Szu-Chi/Ant_Robot/img/Final2 v11.png

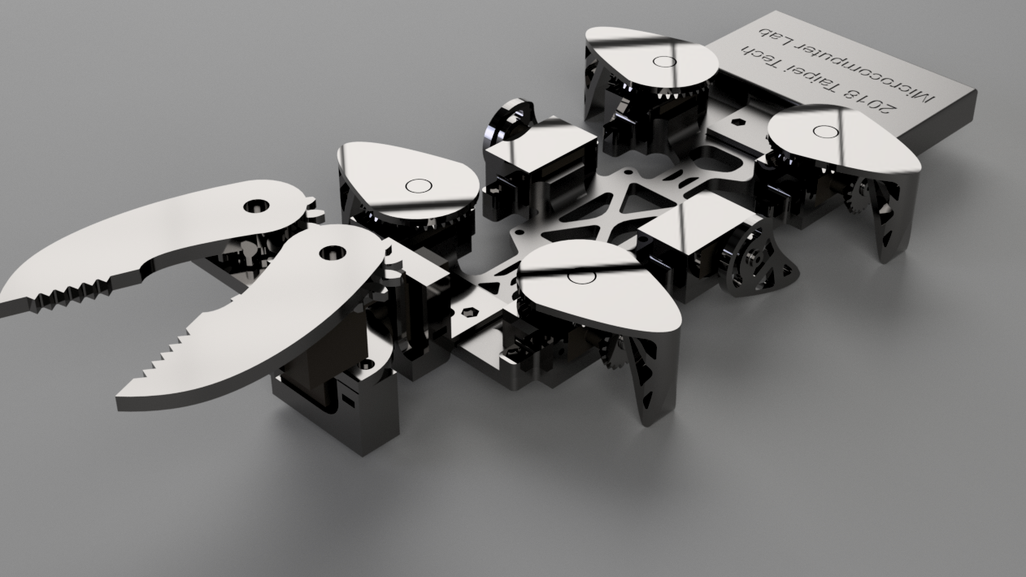
img/Final2 v11.png
