Szu-Chi/Ant_Robot/img/Final2 v12-1.png

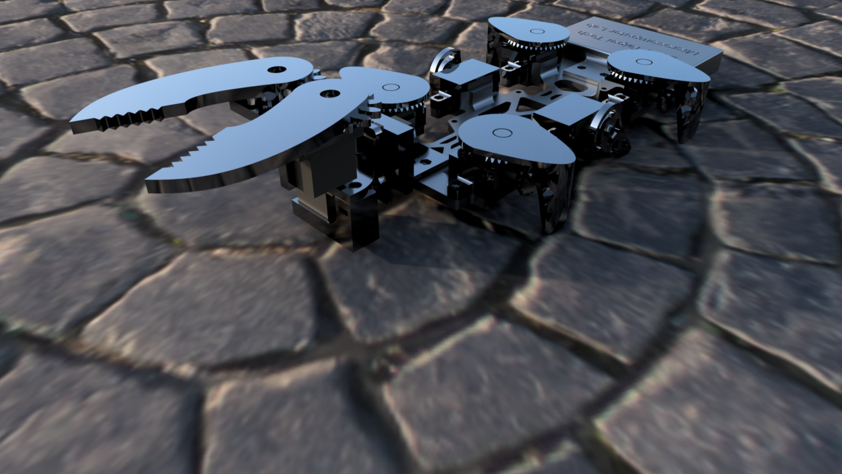
img/Final2 v12-1.png
