Szu-Chi/Ant_Robot/circuit/README.md

## **Note**

All the circuits here, its custom made for milling machines only  !!!
Not for PCB manufacturing !!!

And the controller board is a shield-type PCB
just for our class used the development board
