Szu-Chi/Ant_Robot/doc/微算機原理與應用.pdf

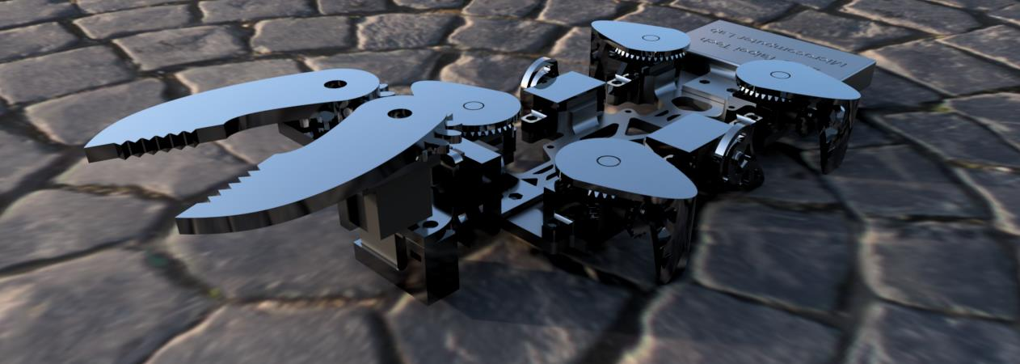
[picture p3: page 1]

# 微算機原理與應用

106360210劉紹祥
106360218莊詠鈞
106360231黃思齊

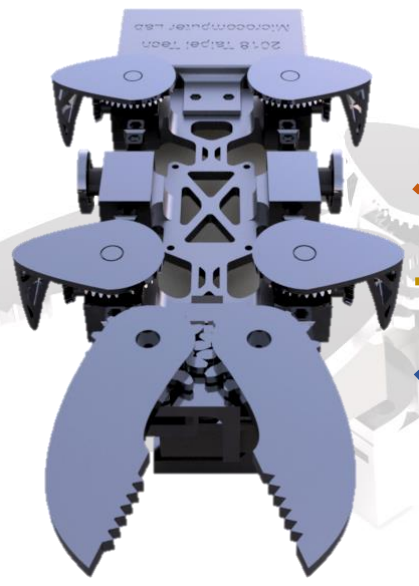
[picture p4: figure]

機構

程式

電路

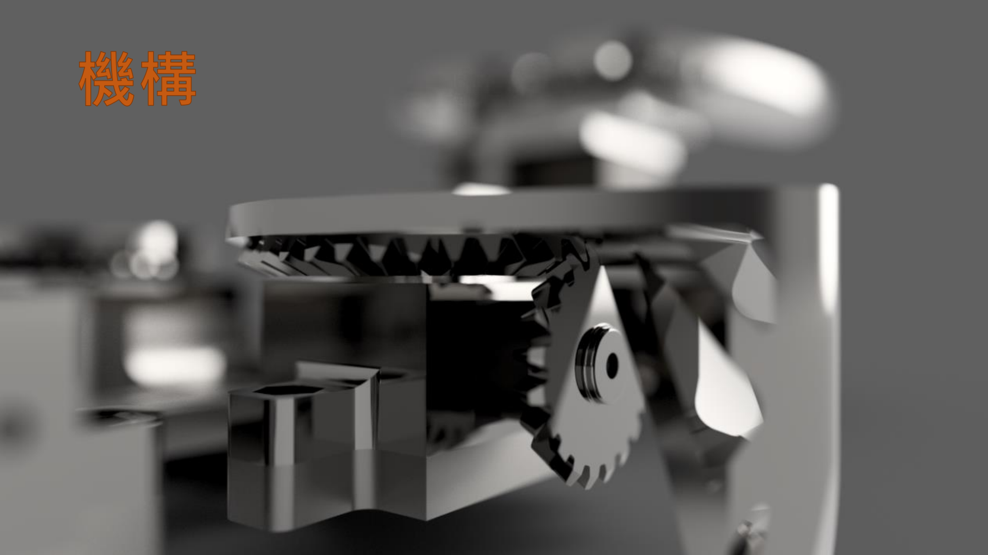
[picture p5: page 3]

# 伺服馬達 MG90

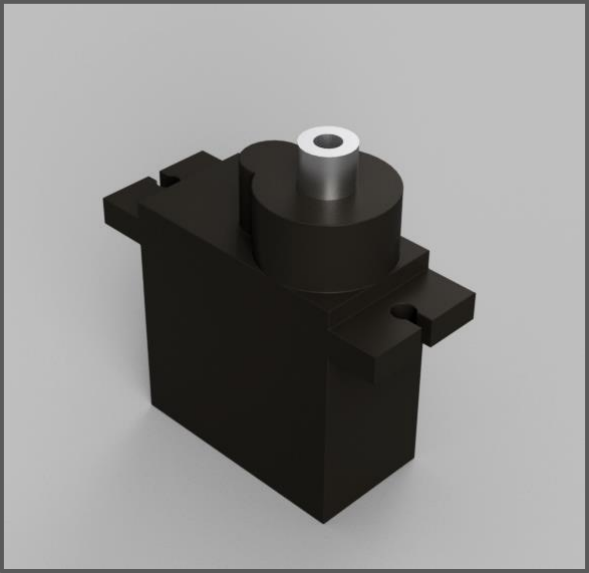
[picture p6: figure]

機構

程式

電路

# 馬達座

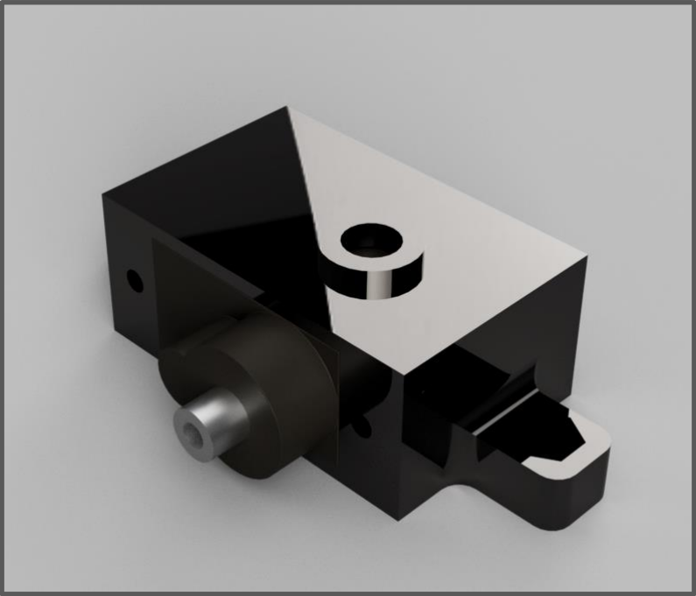
[picture p7: figure]

機構

程式

電路

# 傘齒輪設計

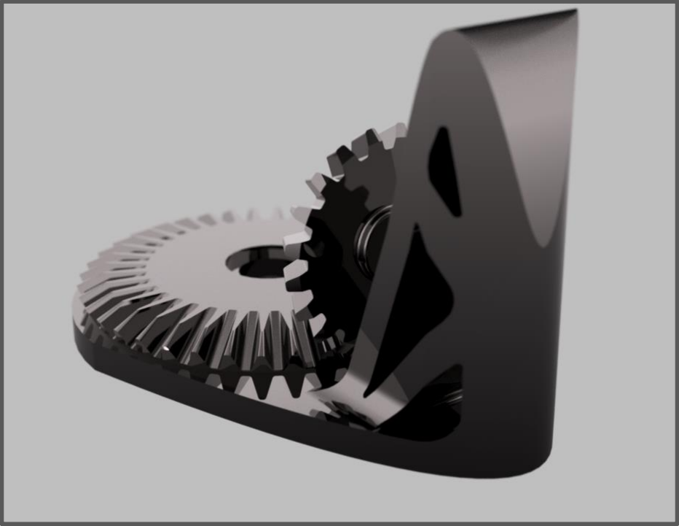
[picture p8: figure]

機構

程式

電路

# 馬達齒輪組固定

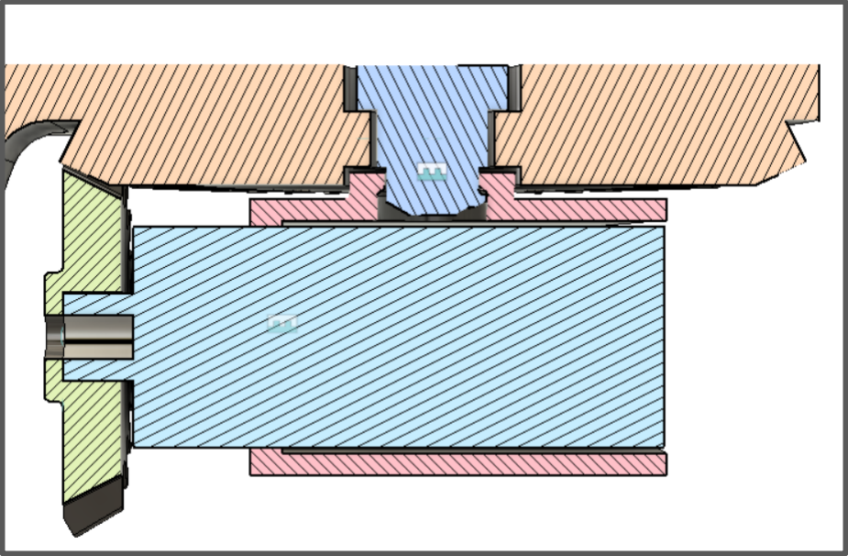
[picture p9: figure]

機構

程式

電路

# 組裝平台

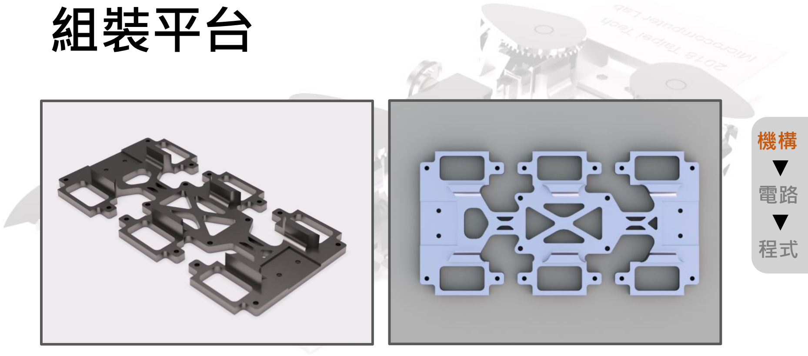
[picture p10: page 8]

機構

程式

電路

# 電池盒

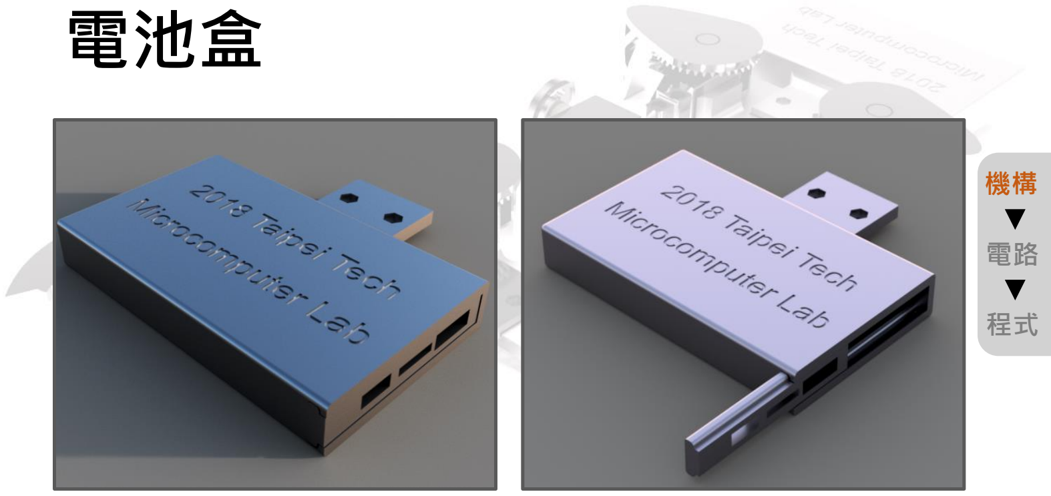
[picture p11: page 9]

機構

程式

電路

# 三軸平台

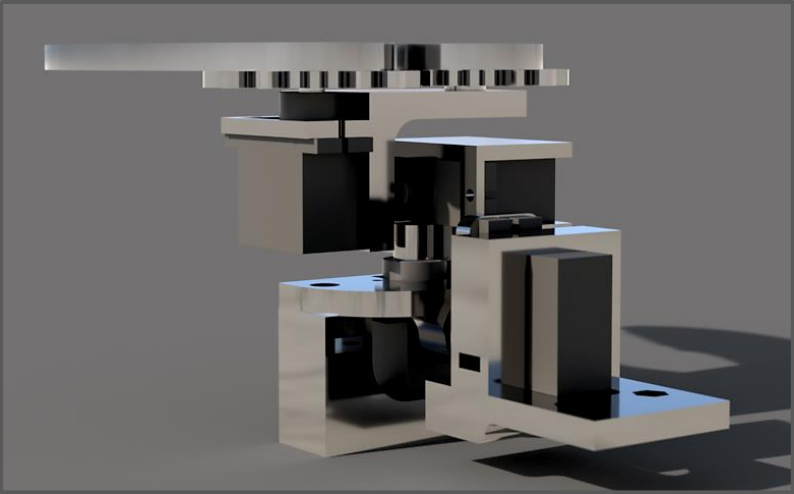
[picture p12: figure]

機構

程式

電路

夾子

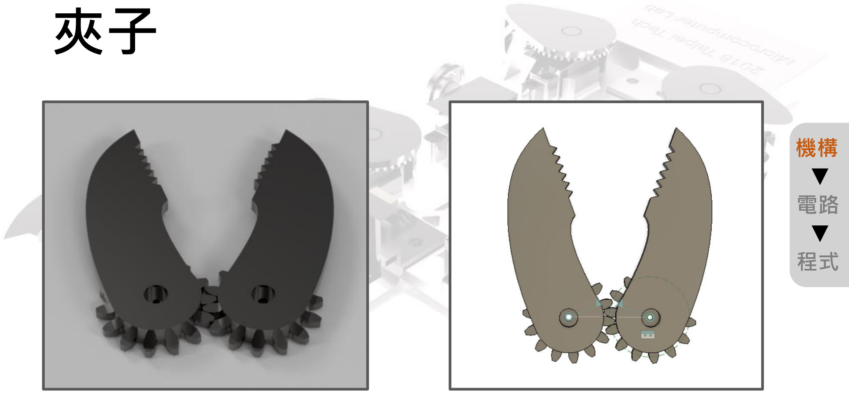
[picture p13: page 11]

機構

程式

電路

# 整體配置

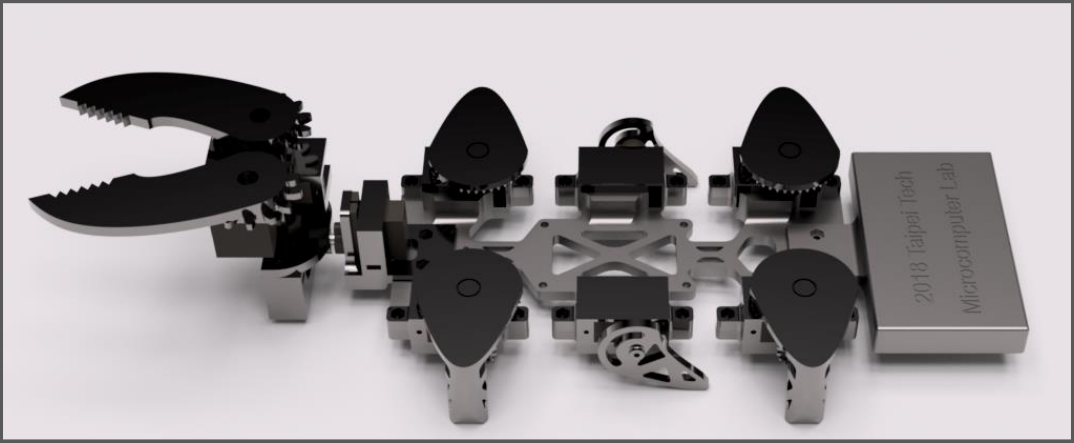
[picture p14: figure]

機構

程式

電路

# 整體配置

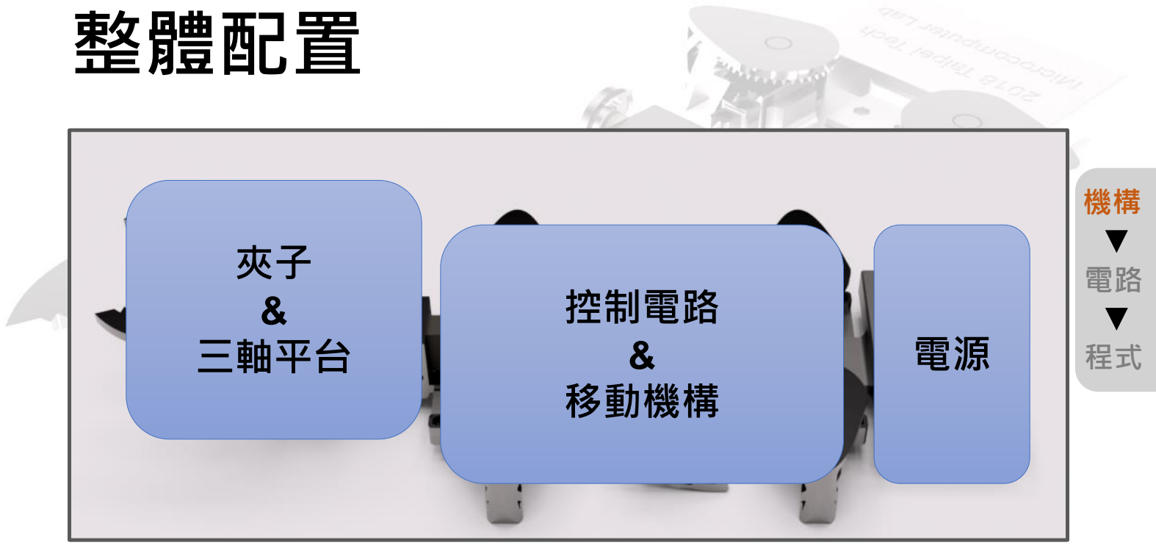
[picture p15: page 13]

機構

程式

## 電路 控制電路 &

## 移動機構

電源

夾子&

## 三軸平台

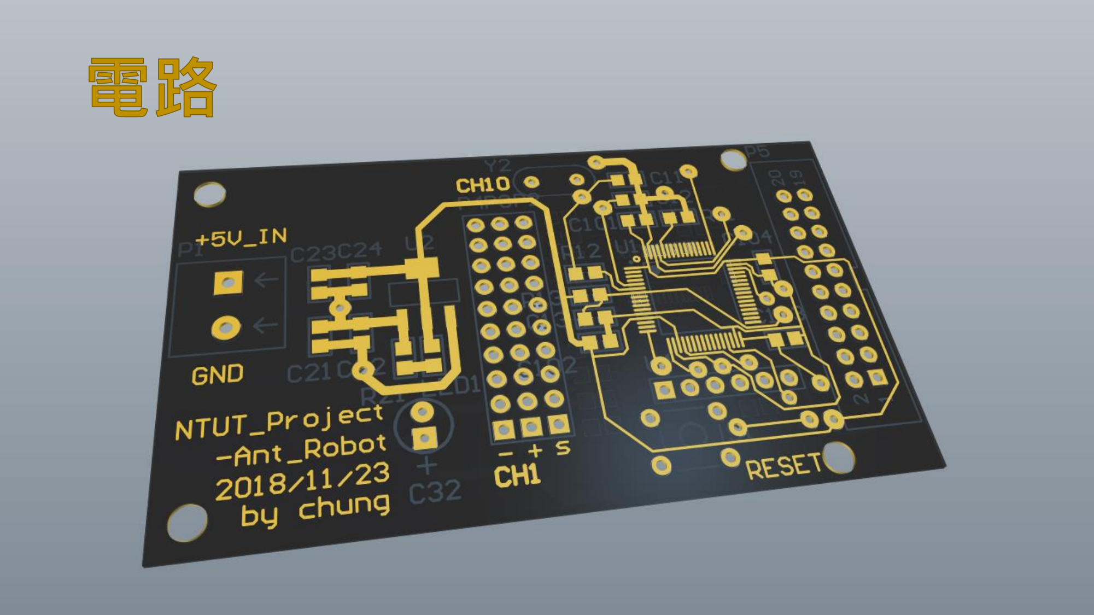
[picture p16: page 14]

電路

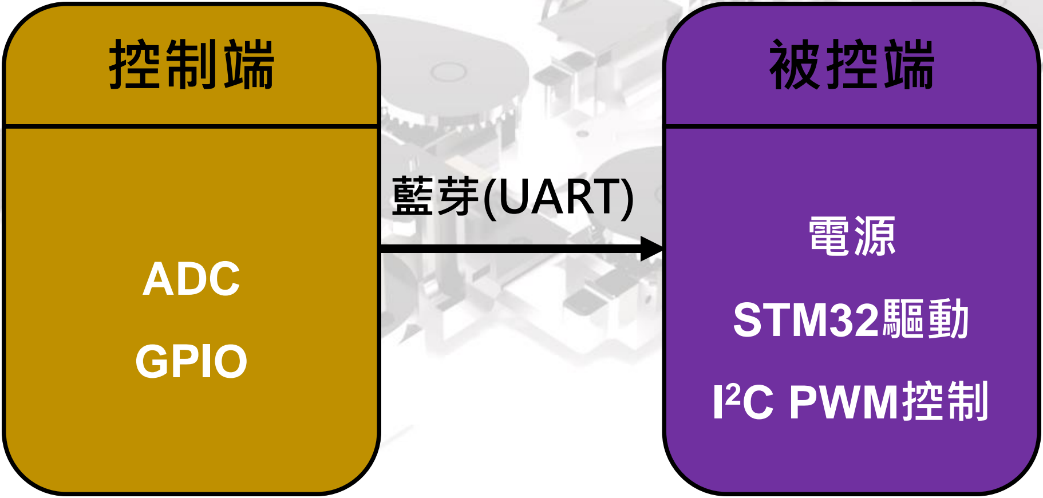
[picture p17: figure]
ADC; GPIO; 控制端; STM32驅動; 2C PWM控制; 被控端; 藍芽(UART)

機構

程式

電路

# 控制端電路

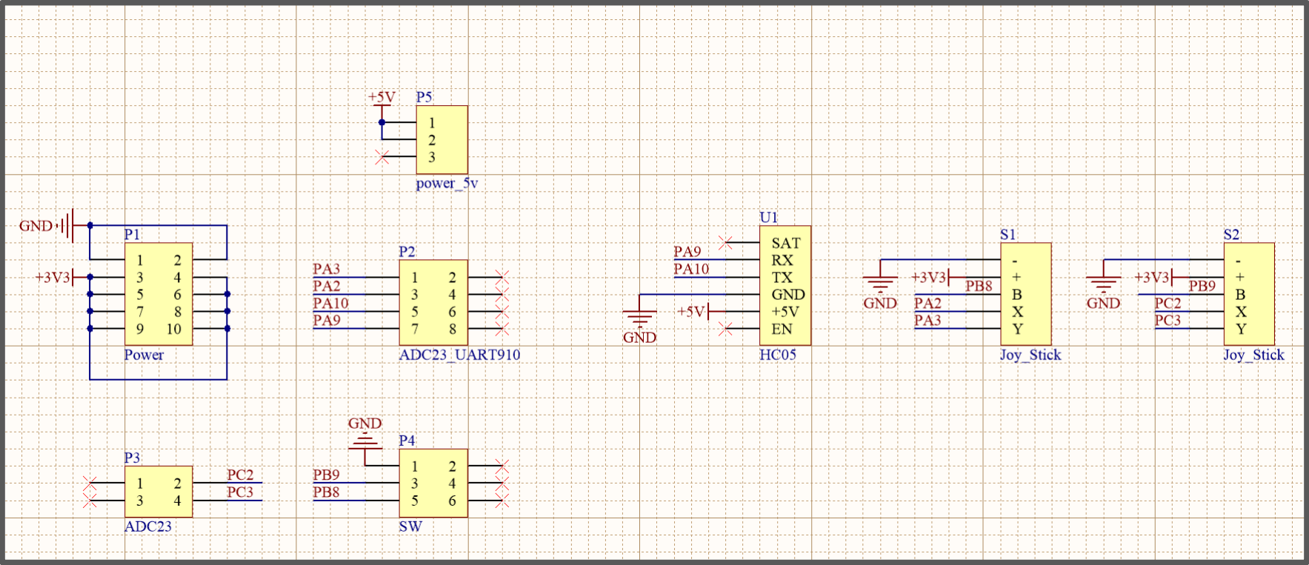
[picture p18: figure]

機構

程式

電路

搖桿

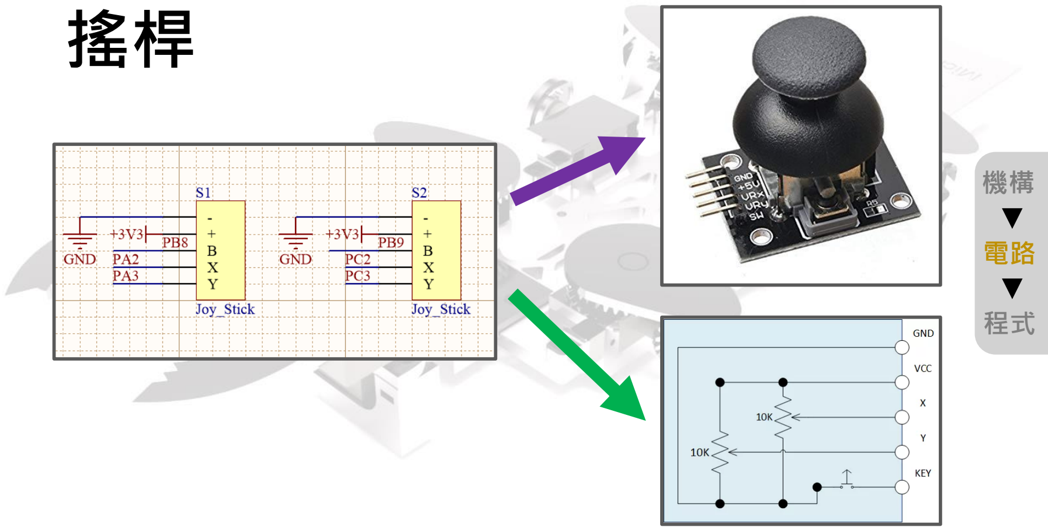
[picture p19: page 17]

機構

程式

電路

# 藍芽模組(HC-05)

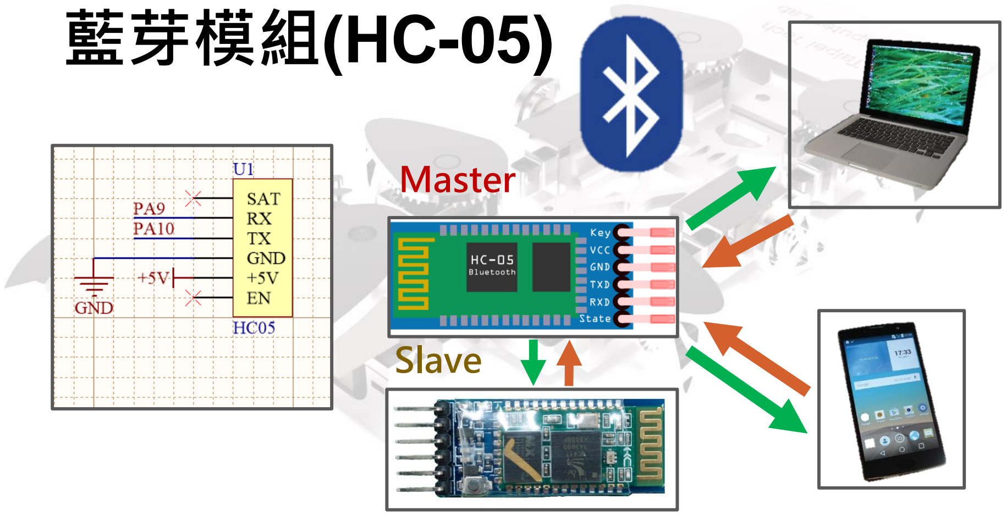
[picture p20: page 18]

## Master

## Slave

# 被控端電路

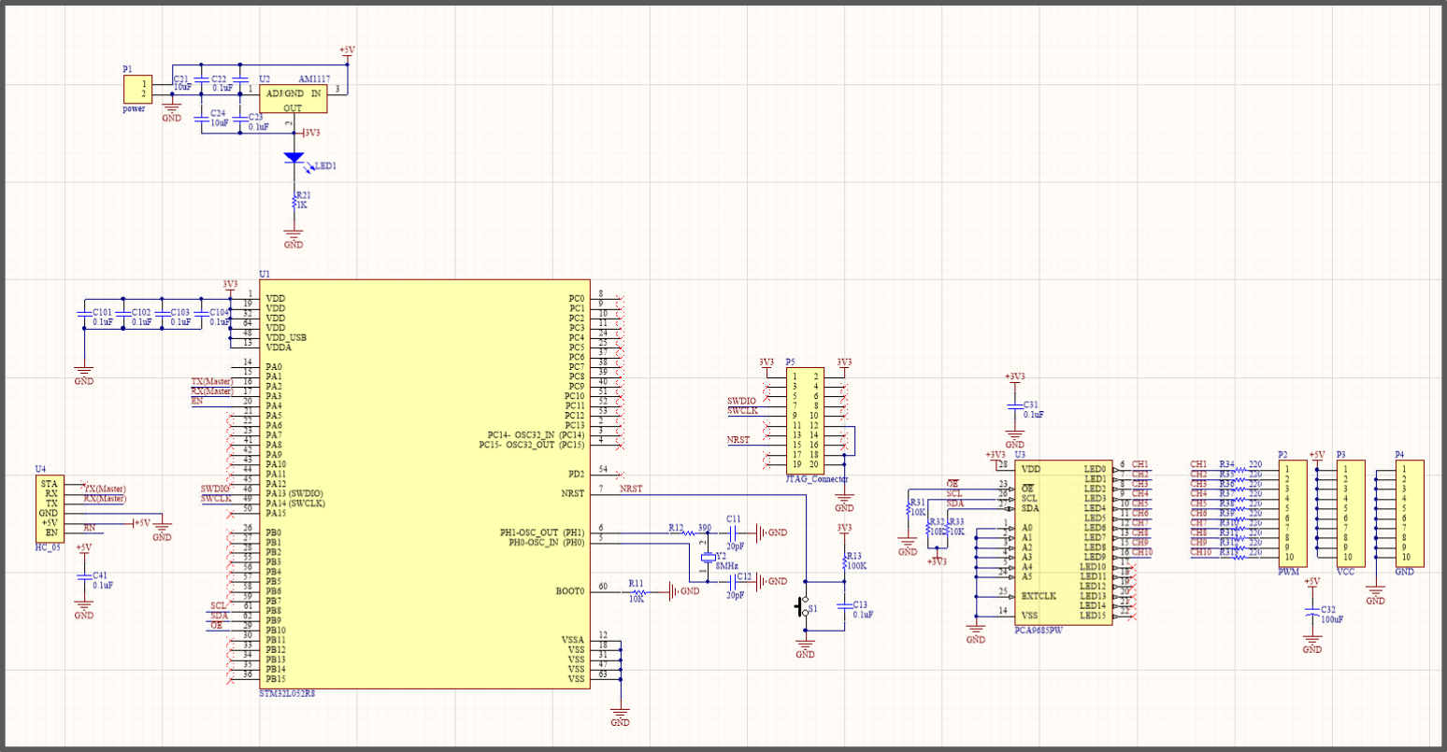
[picture p21: figure]

機構

程式

電路

# 電源電路

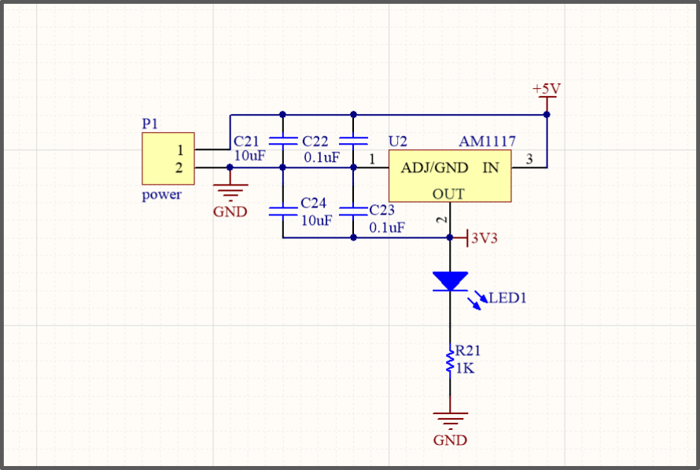
[picture p22: figure]

機構

程式

電路

# STM32驅動電路

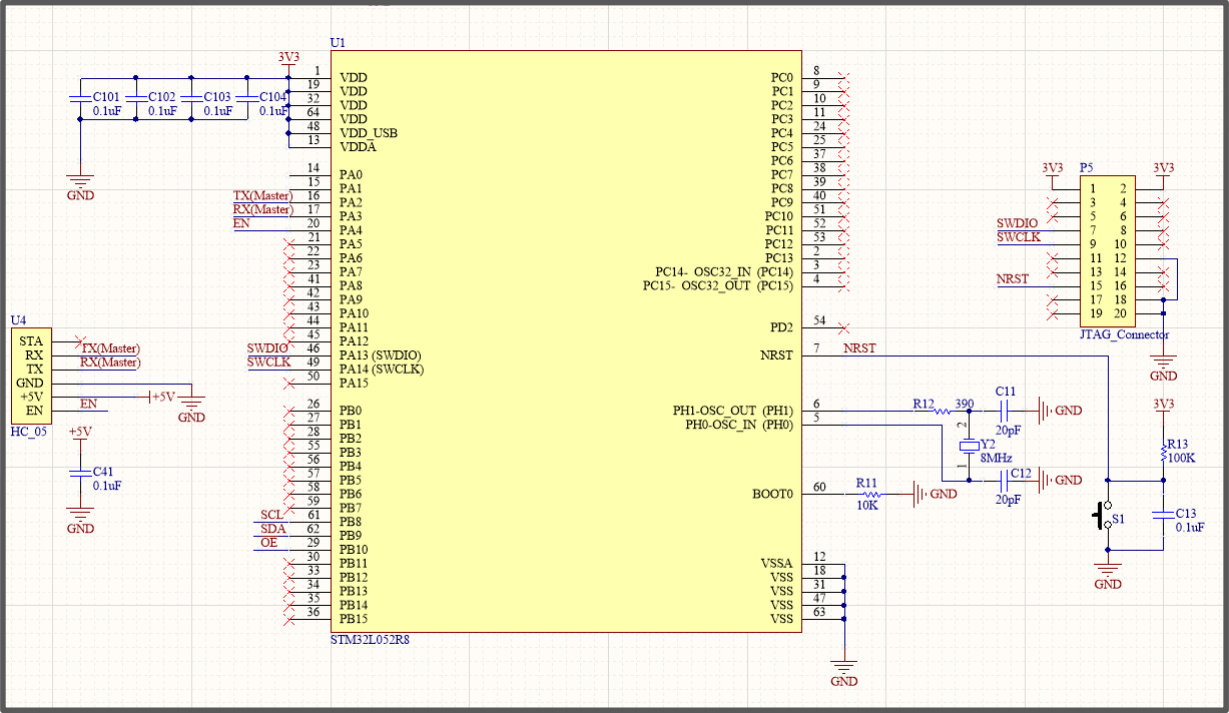
[picture p23: figure]

機構

程式

電路

# I2C PWM驅動IC(PCA9685)

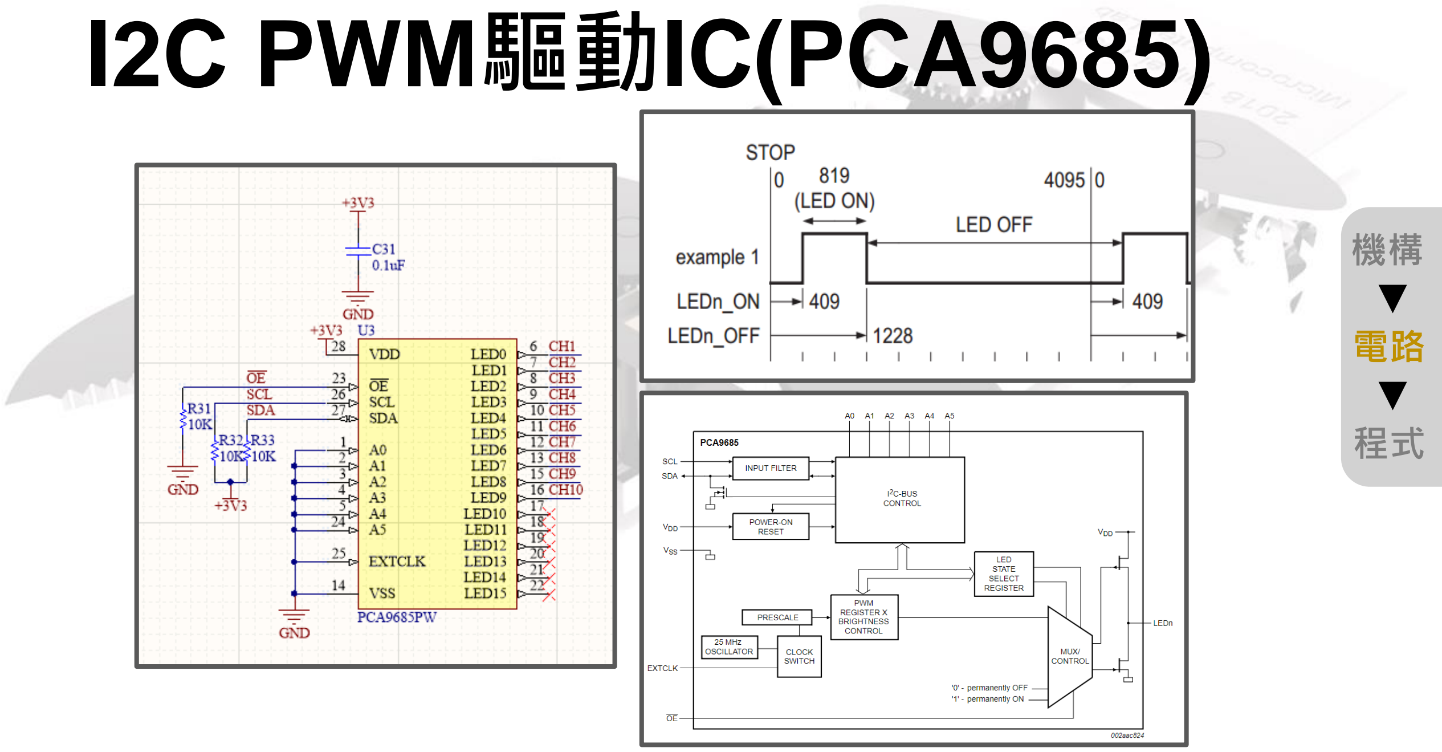
[picture p24: page 22]

機構

程式

電路

# 伺服馬達

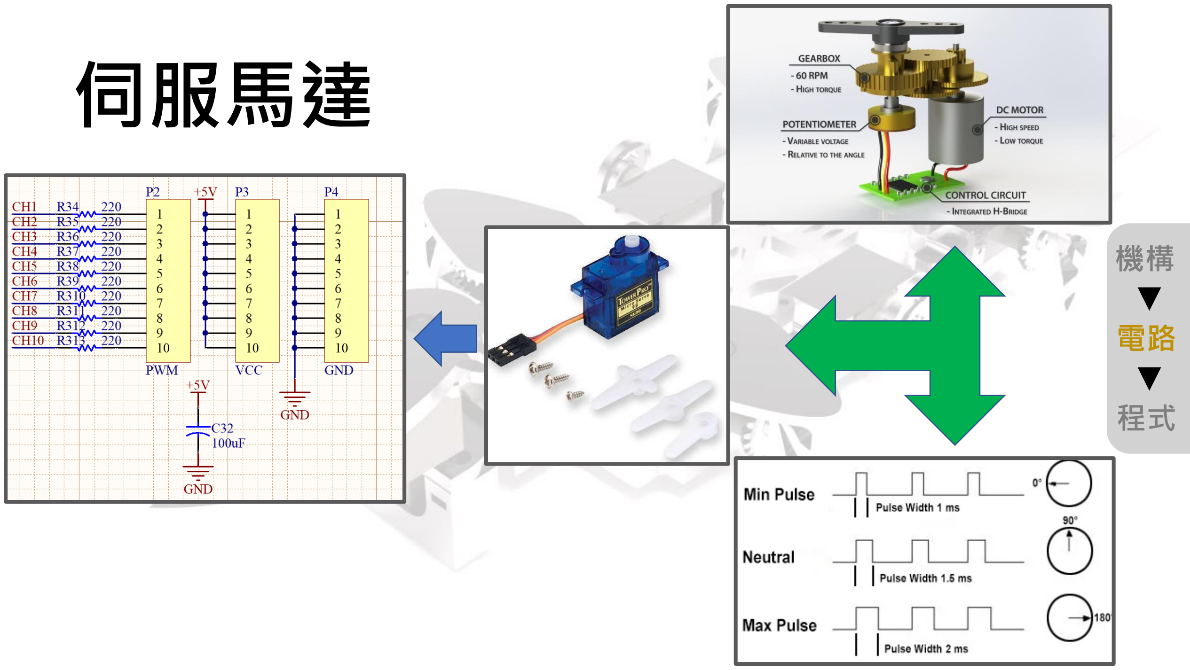
[picture p25: page 23]

機構

程式

電路

# PCB Layout

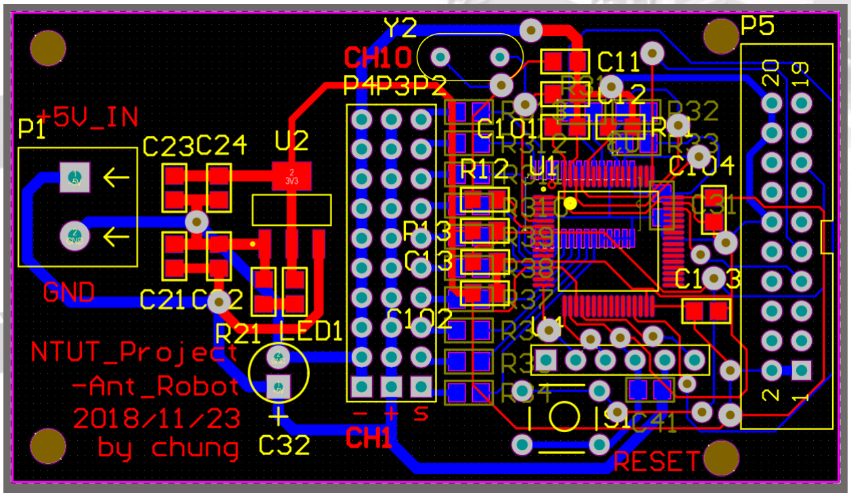
[picture p26: figure]

機構

程式

電路

# PCB Layout

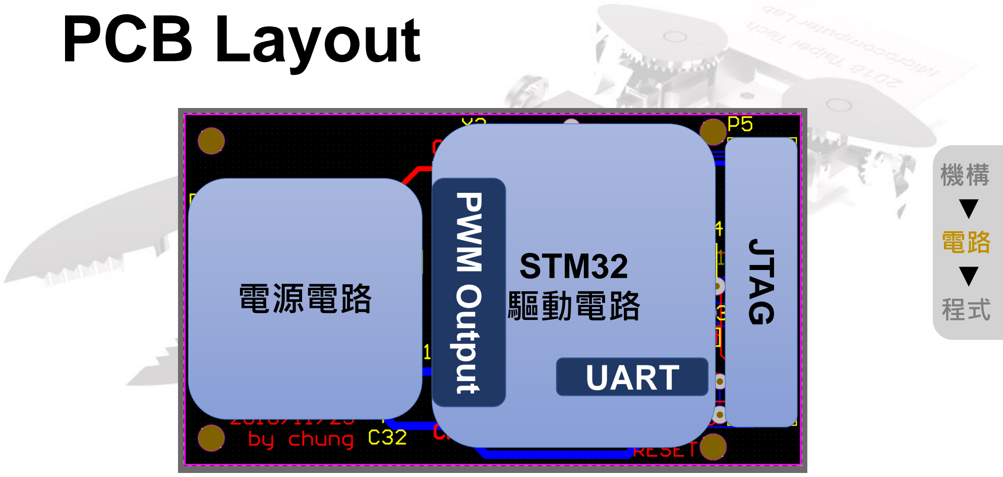
[picture p27: page 25]

## STM32

## 驅動電路

## 電源電路

## JTAG

## UART

## PWM Output

機構

程式

電路

# Gerber file & NC drill

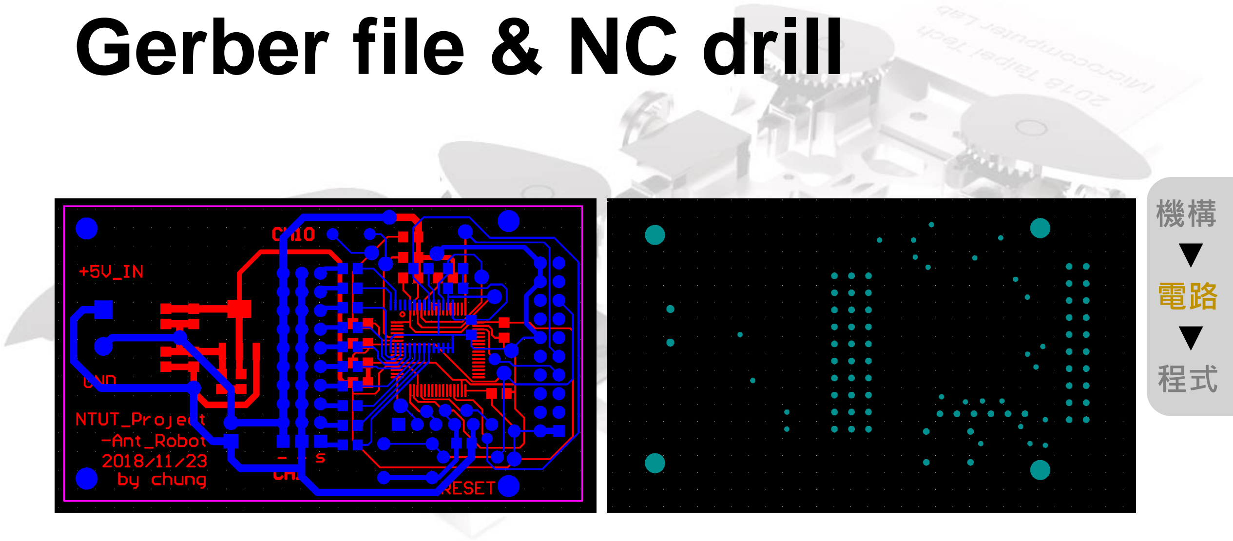
[picture p28: page 26]

機構

程式

電路

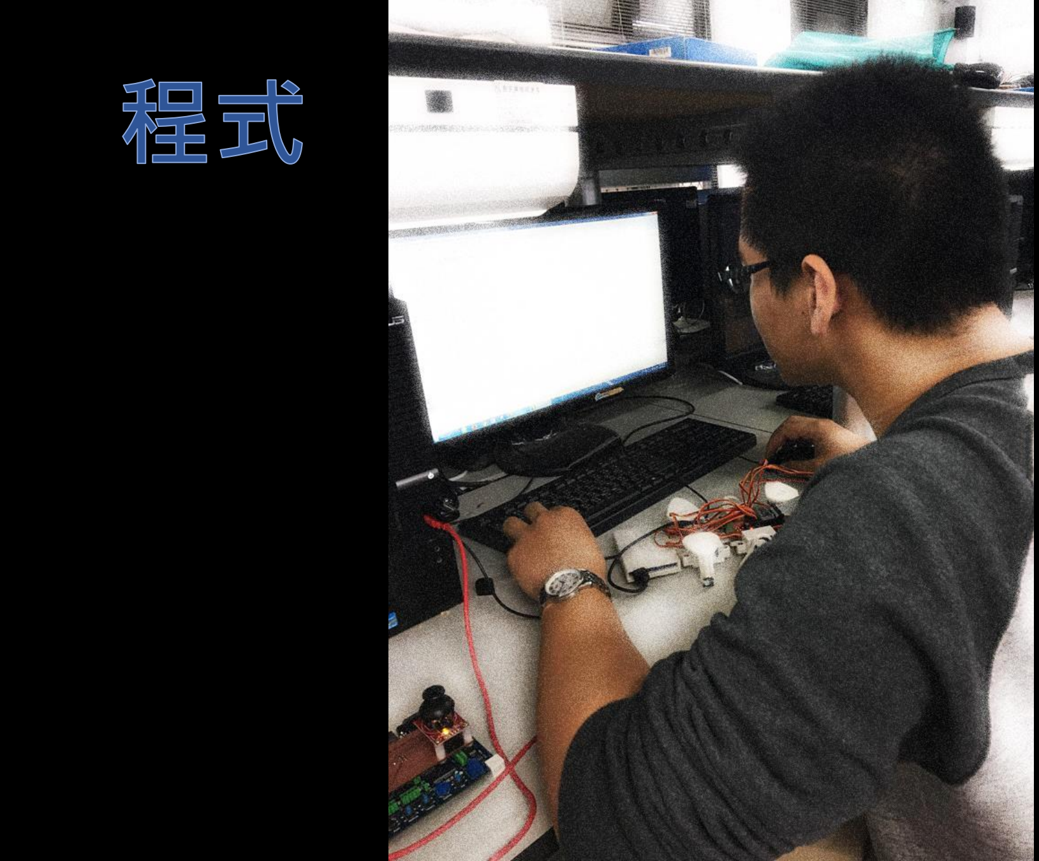
[picture p29: figure]

機構

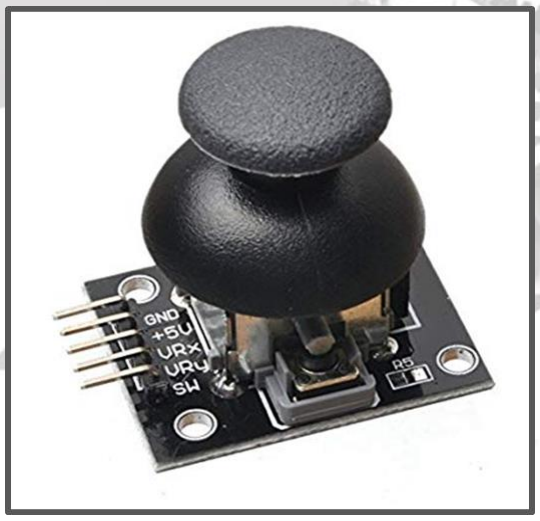
[picture p30: figure]
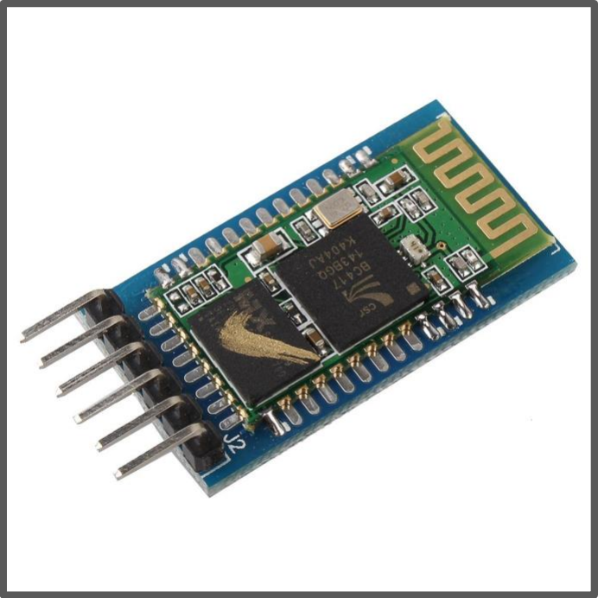
[picture p31: figure]

程式

電路

# 控制端

ADC DMA | UART

# DMA

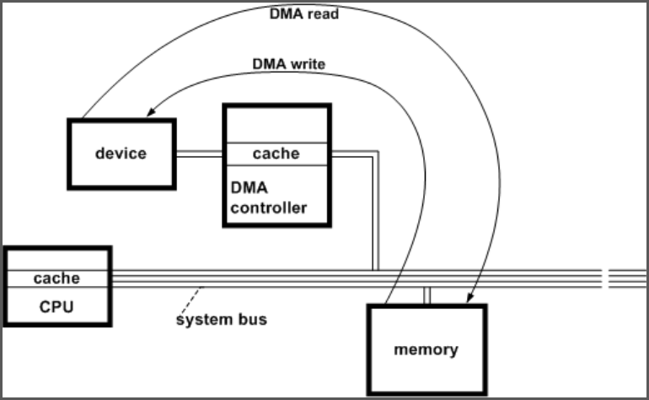
[picture p32: figure]

機構

程式

電路

# ADC DMA

機構

程式

電路

HAL_ADC_Start_DMA(&hadc1,adc_temp,5);

uint32_t X1_Value=2048,Y1_Value=2048,X2_Value=0,Y2_Value=0,VR_Value=0;

void HAL_ADC_ConvCpltCallback(ADC_HandleTypeDef* hadc) {
X1_Value = adc_temp[0];
Y1_Value = adc_temp[1];
X2_Value = adc_temp[2];
Y2_Value = adc_temp[3];
VR_Value = adc_temp[4];
}

# UART Package

機構

程式

電路

4 | 5 | 6 | 7
Angle3 | SW_Clip | End | NC
0 | 1 | 2 | 3
Command | Speed | Angle1 | Angle2

機構

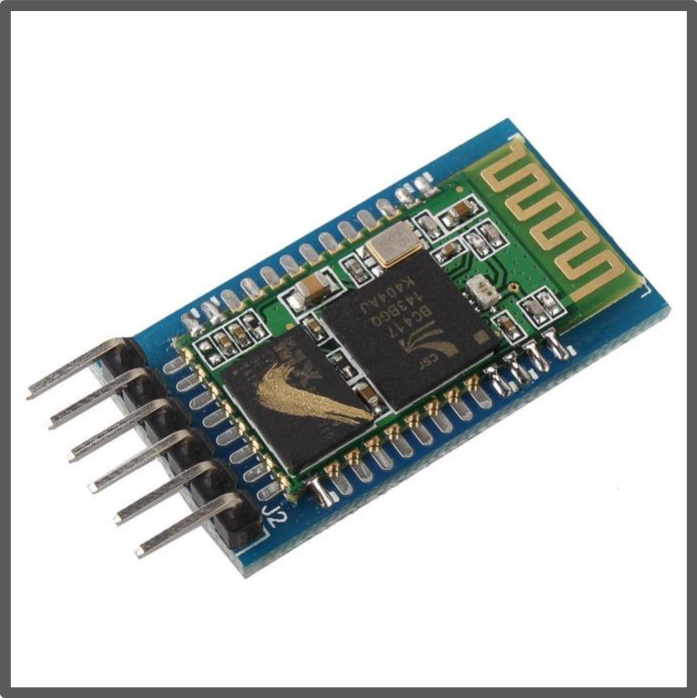
[picture p33: figure]
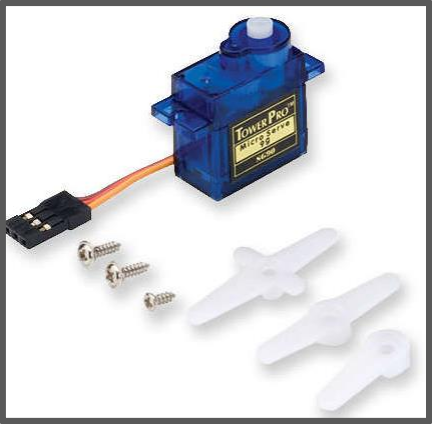
[picture p34: figure]
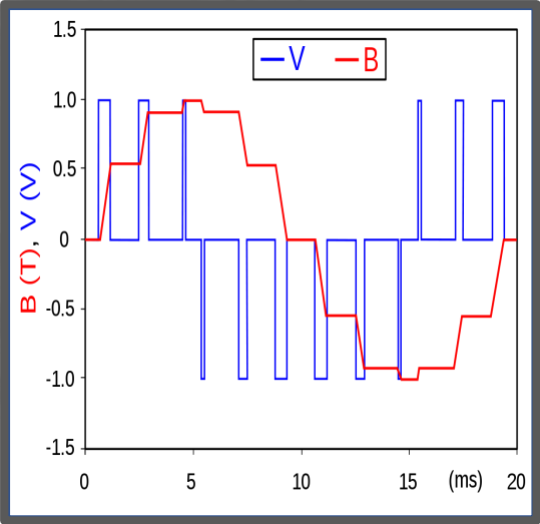
[picture p35: figure]

程式

電路

# 被控端

UART | setAngle | setPWM

# Main loop

while (1) {

if(command=='F') { Move_Forword(); }

else if(command=='R') { Turn_Right(); }

else if(command=='L') { Turn_Left(); }

else if(command=='S') { Reset_Position(); }

}

機構

程式

電路

# Decoding UART Package

void HAL_UART_RxCpltCallback(UART_HandleTypeDef *huart) { if(huart->Instance==USART2) { if(str1[6]=='E’) {
command = str1[0]; speed = str1[1]; angle1 = (int)str1[2]; angle2 = (int)str1[3]; angle3 = (int)str1[4]; clip = str1[5];
}
HAL_UART_Receive_IT(&huart2,str1,7); //Enable rx interrupt every time
}
}

機構

程式

電路

# setAngle

void setAngle(uint8_t num, uint8_t angle){

int pulse_wide, analog_value;

pulse_wide = map(angle, 0, 180, MIN_PULSE_WIDTH, MAX_PULSE_WIDTH);

analog_value = (int)((float)(pulse_wide) / 1000000 * 50 * 4096);

setPWM(num,0,analog_value);

}

機構

程式

電路

# setPWM - I

2C

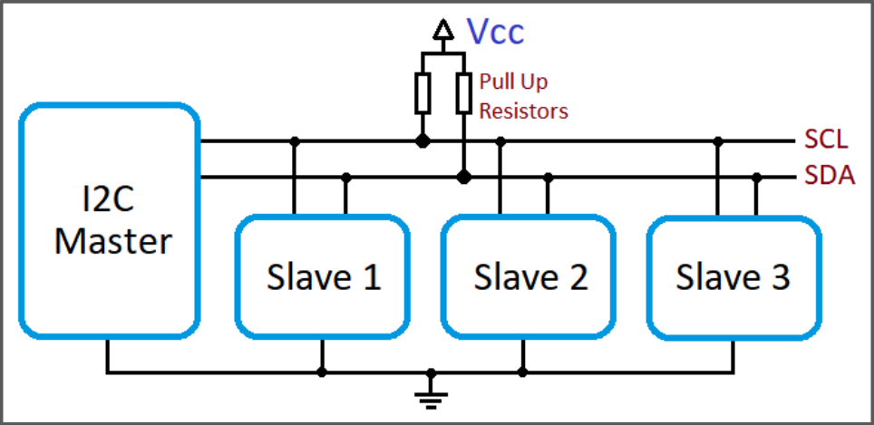
[picture p36: figure]

機構

程式

電路

# setPWM

機構

程式

電路

void setPWM(uint8_t num, uint16_t on, uint16_t off) { uint8_tdata_buf[]={on,(on>>8),off,(off>>8)}; I2C_WRITE_buf(LED0_ON_L+4*(num),data_buf,4); }

Slave address | Control register | Data for register
1 | A5:A0 | D7:D0 | D7:D0

# 成品照1

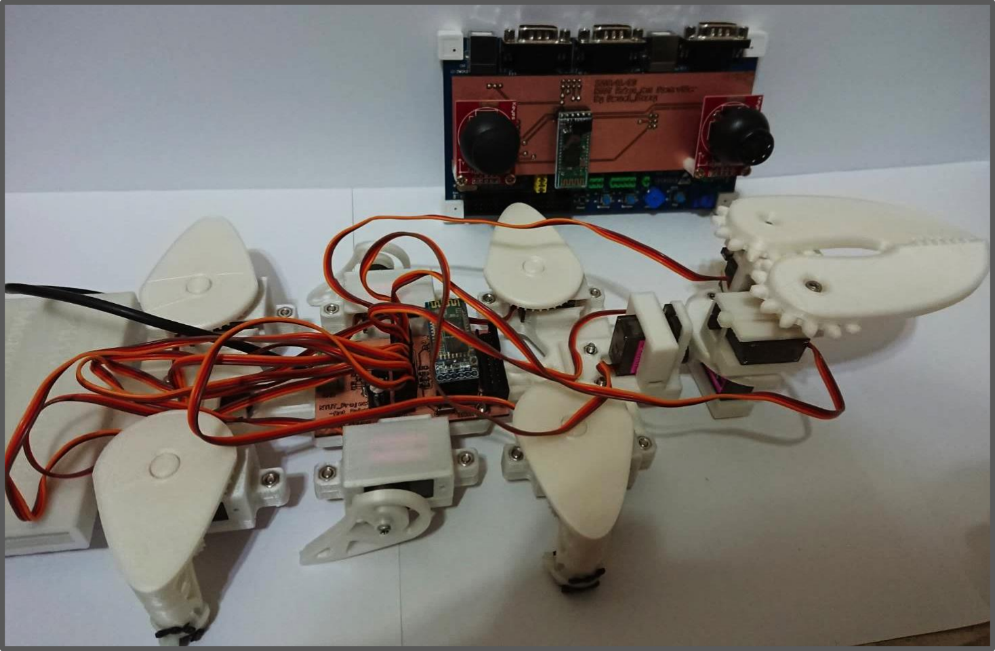
[picture p37: figure]

# 成品照2

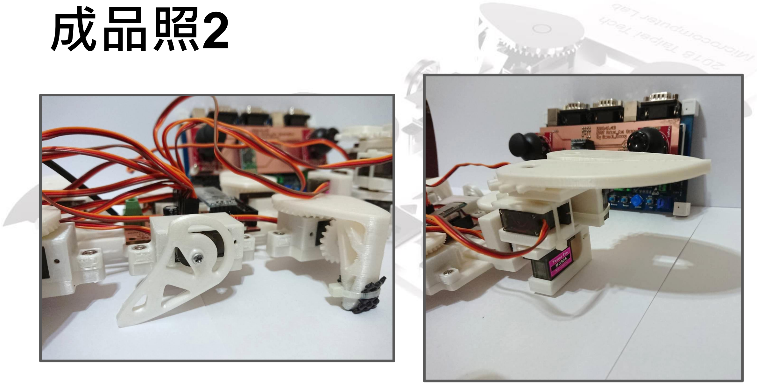
[picture p38: page 39]

# 成品照3

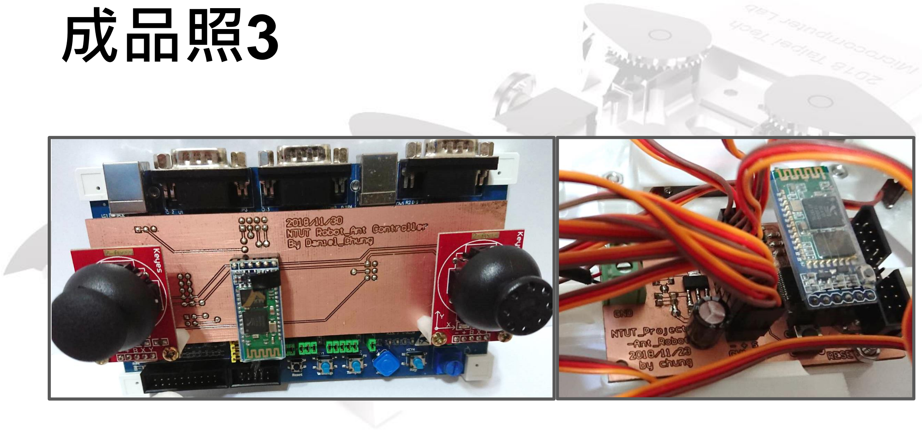
[picture p39: page 40]

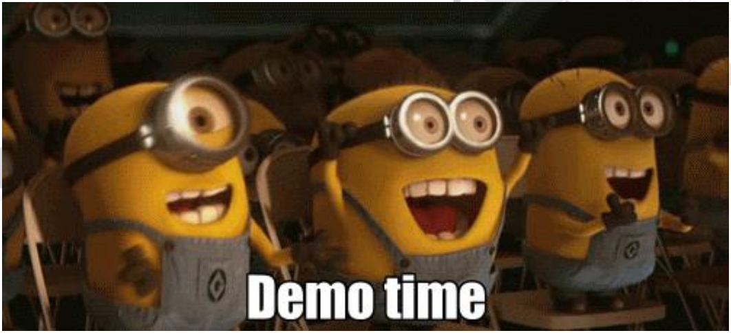
[picture p40: figure]
