Szu-Chi/Ant_Robot/img/Final2 v10.png

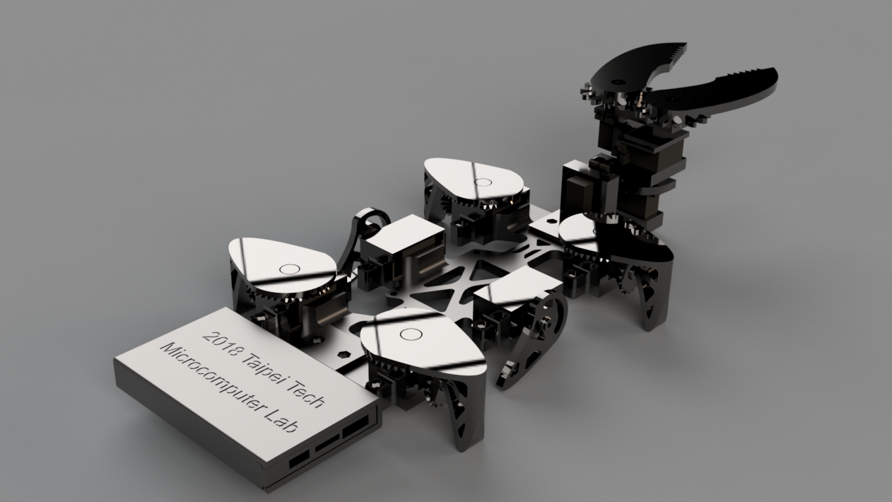
img/Final2 v10.png
