Szu-Chi/Ant_Robot/img/Final2 v12-2.png

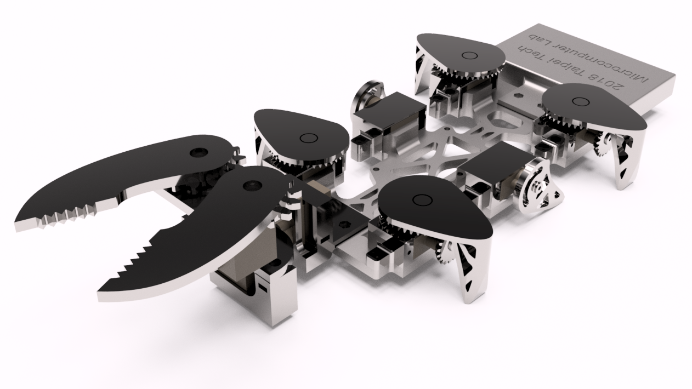
img/Final2 v12-2.png
