Szu-Chi/Ant_Robot/img/Final2 v12-3.png

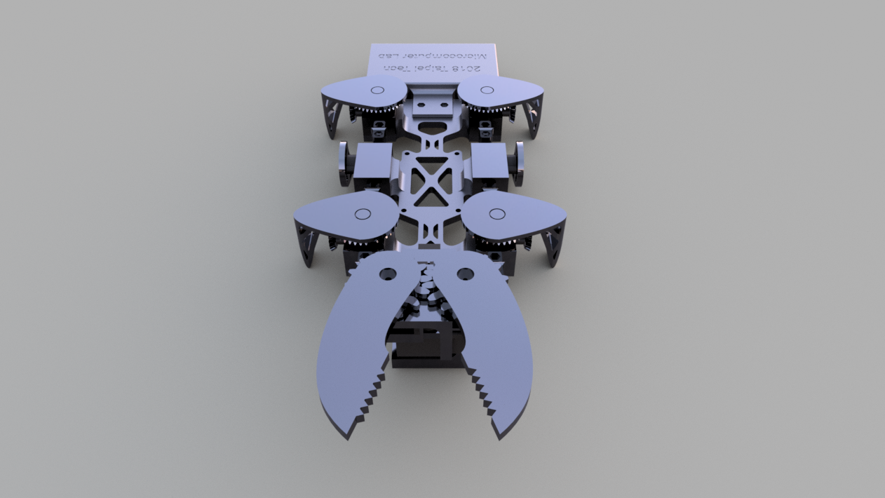
img/Final2 v12-3.png
