Szu-Chi/Ant_Robot/img/Final2 v14 -4.png

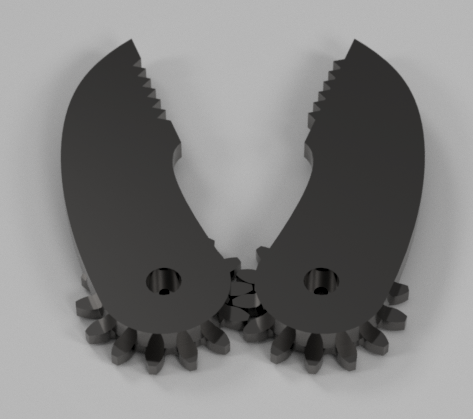
img/Final2 v14 -4.png
