Szu-Chi/Ant_Robot/img/Final2 v14-2.png

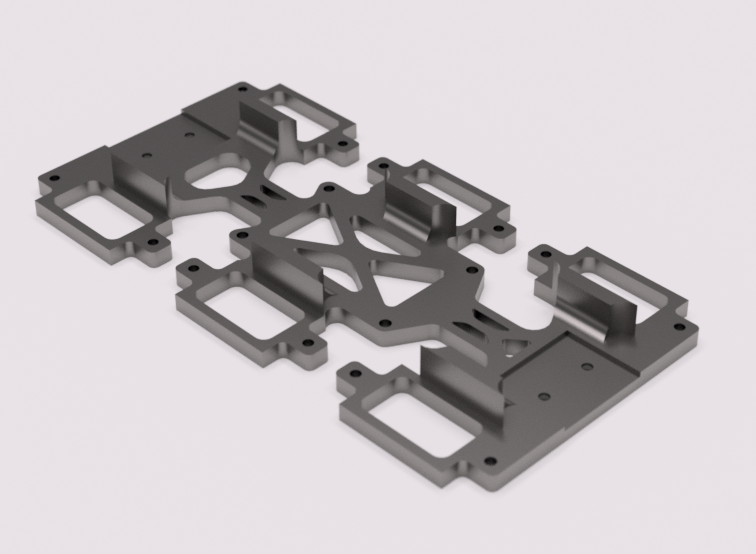
img/Final2 v14-2.png
