Szu-Chi/Ant_Robot/img/Final2 v14-3.png

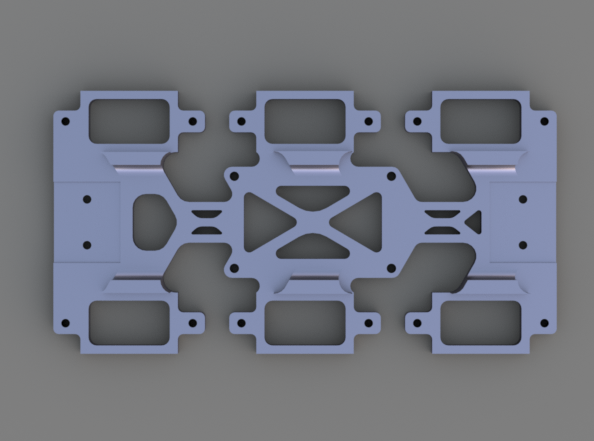
img/Final2 v14-3.png
