Szu-Chi/Ant_Robot/img/Final2 v14-5.png

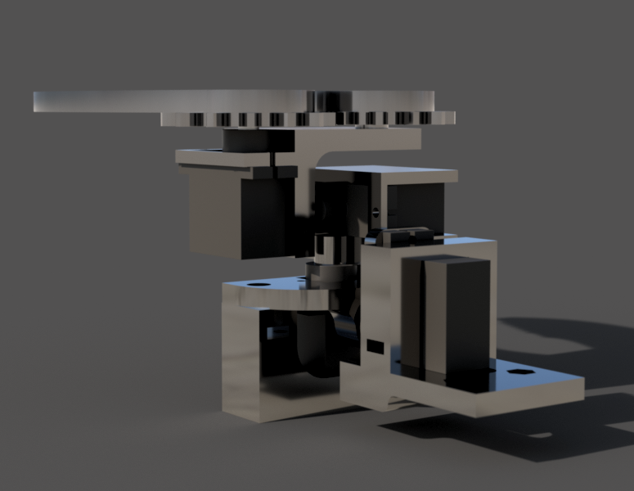
img/Final2 v14-5.png
