Szu-Chi/Ant_Robot/img/Gear v8-1.png

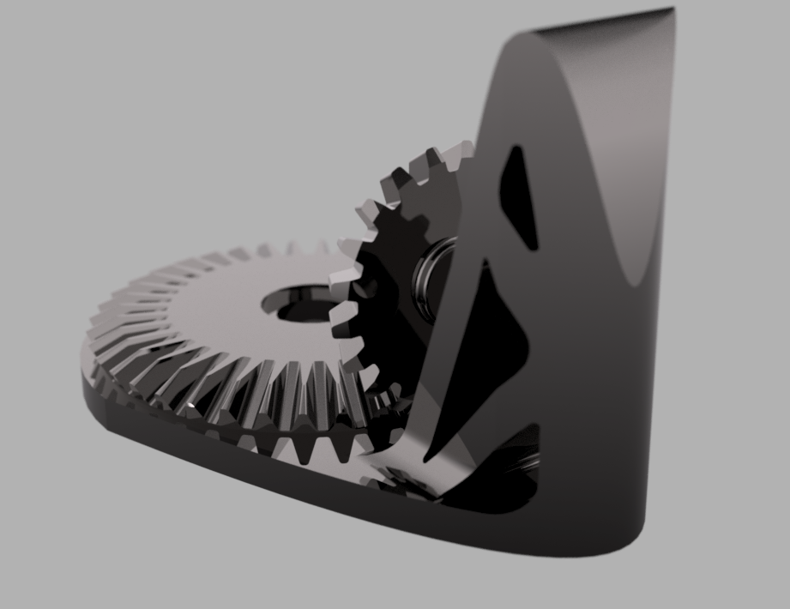
img/Gear v8-1.png
