Szu-Chi/Ant_Robot/img/Gear v8.png

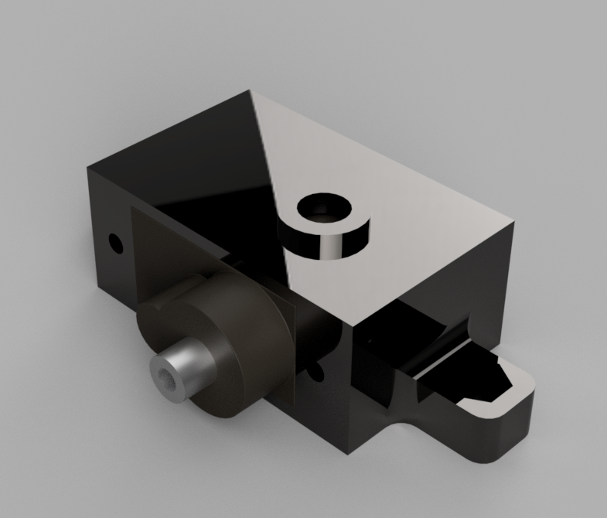
img/Gear v8.png
