Szu-Chi/Ant_Robot/img/MG90S v1.png

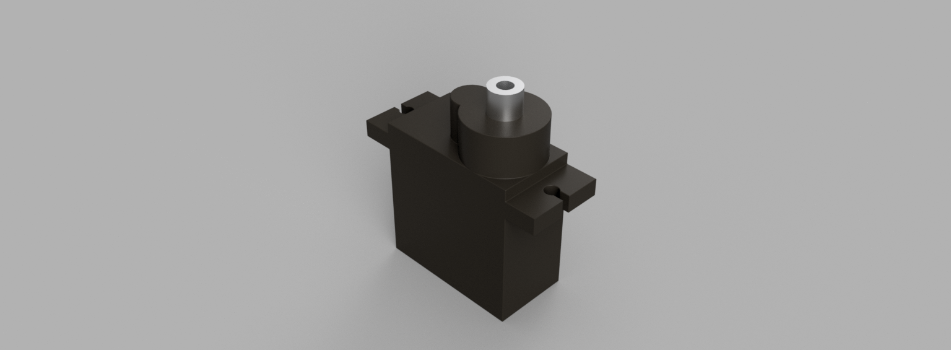
img/MG90S v1.png
