Szu-Chi/Ant_Robot/img/擷取.PNG

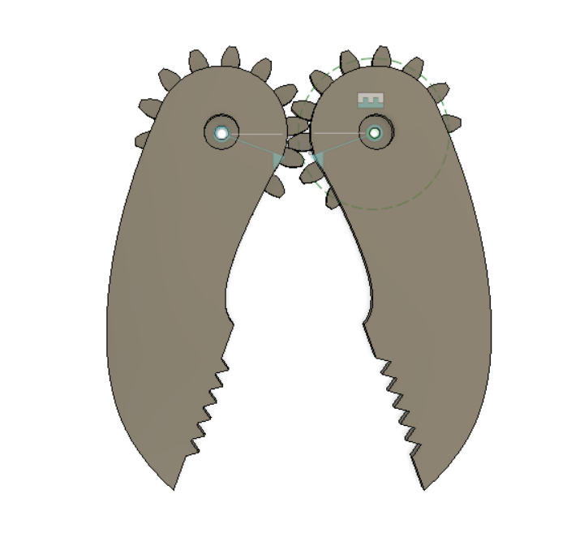
img/擷取.PNG
