Szu-Chi/Ant_Robot/3d model/neckServoHousing.stl

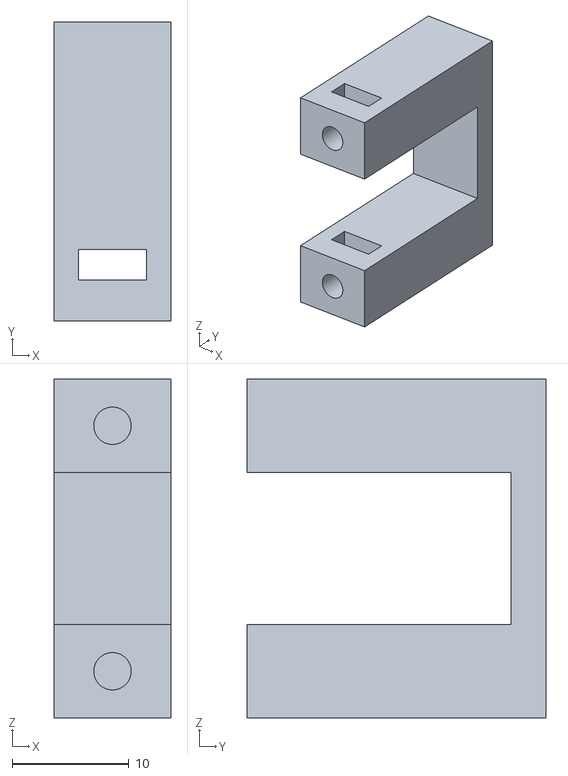
[picture p54: CAD file, 2022-07-29]
3d model/neckServoHousing.stl
10.0 x 25.6 x 29.0
