Szu-Chi/Ant_Robot/3d model/Servo Housing_Latch(Mirror).stl

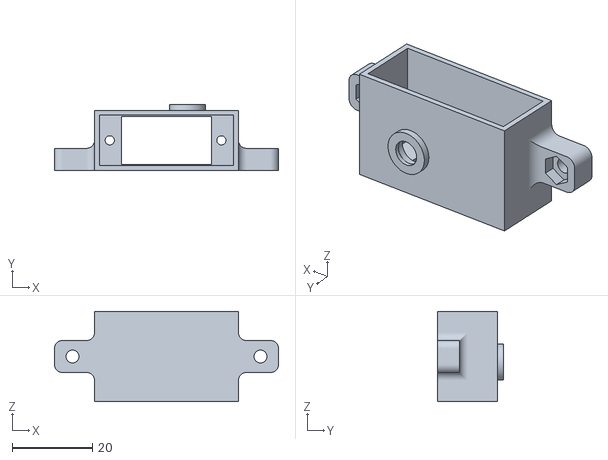
[picture p55: CAD file, 2022-07-29]
3d model/Servo Housing_Latch(Mirror).stl
56.0 x 16.4 x 22.6
