Szu-Chi/Ant_Robot/3d model/foot.stl

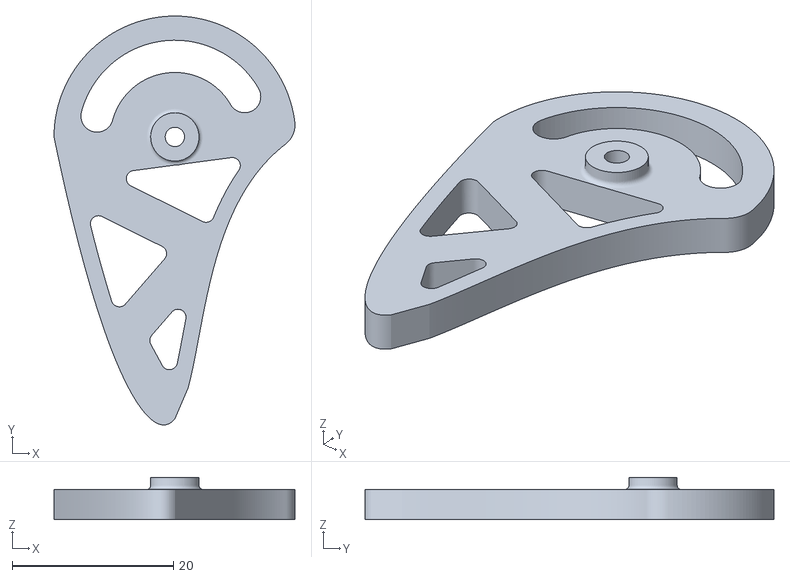
[picture p56: CAD file, 2022-07-29]
3d model/foot.stl
29.9 x 50.7 x 5.25
