Szu-Chi/Ant_Robot/3d model/Head.stl

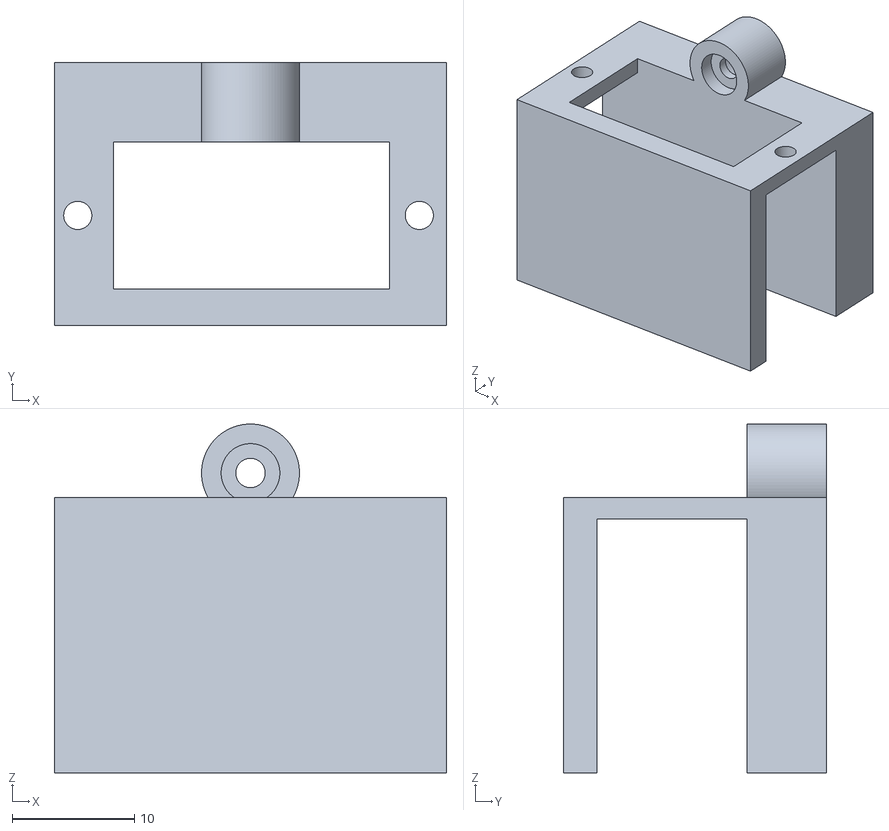
[picture p57: CAD file, 2022-07-29]
3d model/Head.stl
32.0 x 21.5 x 28.5
