Szu-Chi/Ant_Robot/3d model/headServoHousing.stl

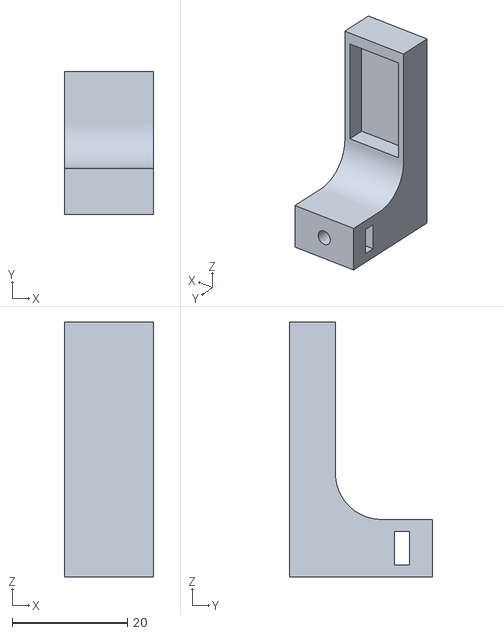
[picture p58: CAD file, 2022-07-29]
3d model/headServoHousing.stl
15.5 x 24.8 x 44.3
