Szu-Chi/Ant_Robot/3d model/neck.stl

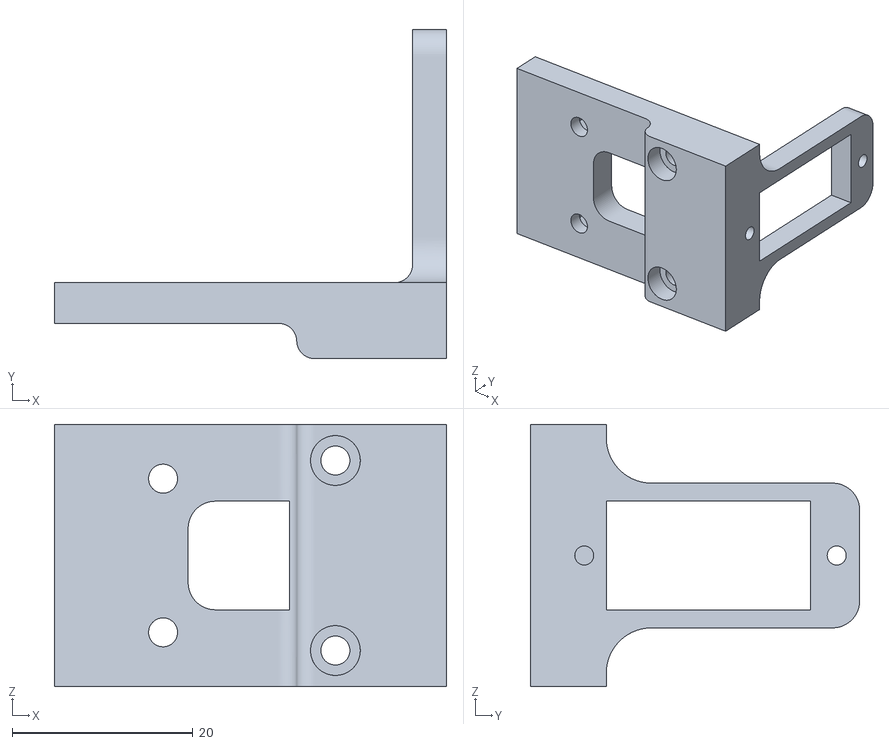
[picture p59: CAD file, 2022-07-29]
3d model/neck.stl
43.3 x 36.4 x 29.0
