Szu-Chi/Ant_Robot/3d model/abdomen.stl

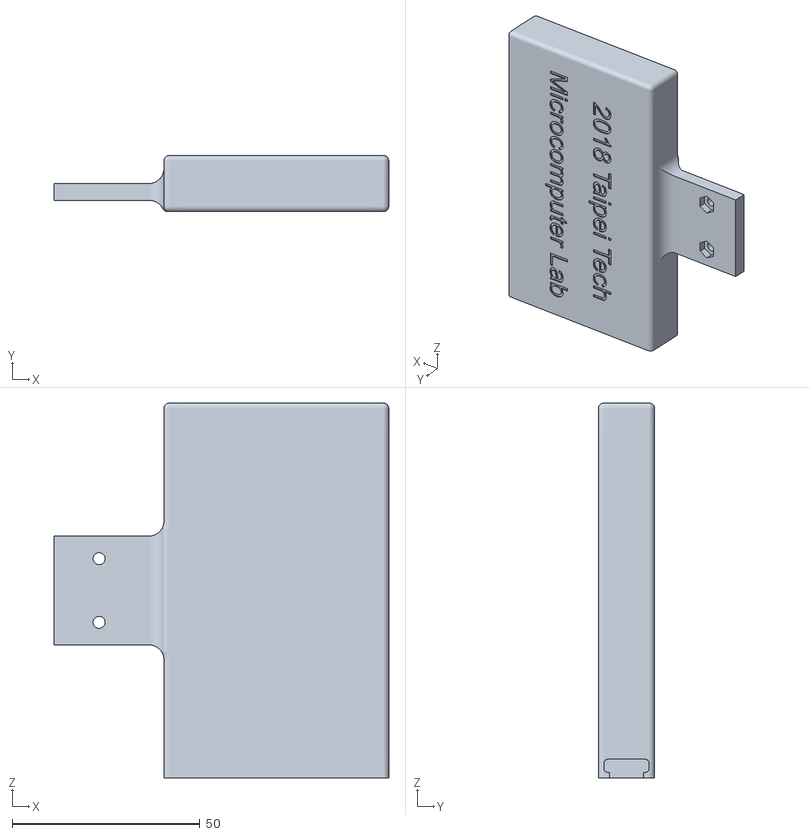
[picture p60: CAD file, 2022-07-29]
3d model/abdomen.stl
89.3 x 15.0 x 100.0
