Szu-Chi/Ant_Robot/3d model/ServoHousing.stl

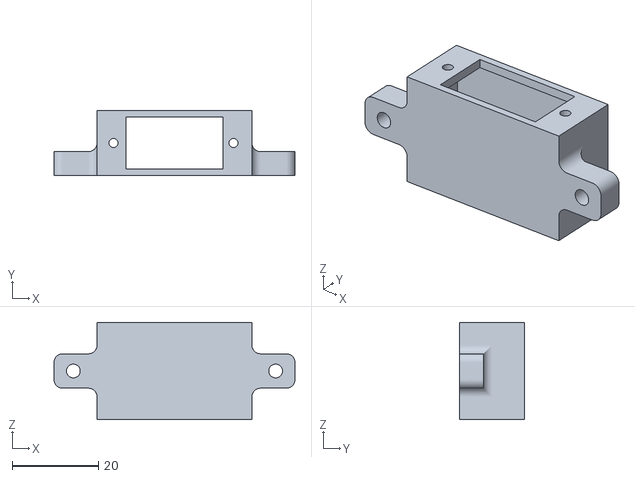
[picture p61: CAD file, 2022-07-29]
3d model/ServoHousing.stl
56.0 x 15.0 x 22.6
