Szu-Chi/Ant_Robot/3d model/Latch1(Mirror).stl

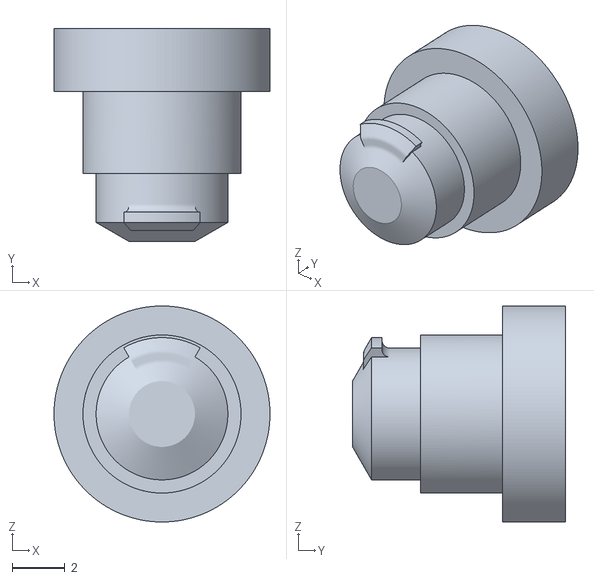
[picture p62: CAD file, 2022-07-29]
3d model/Latch1(Mirror).stl
8.20 x 8.09 x 8.20
