Szu-Chi/Ant_Robot/3d model/ClipServoHousing.stl

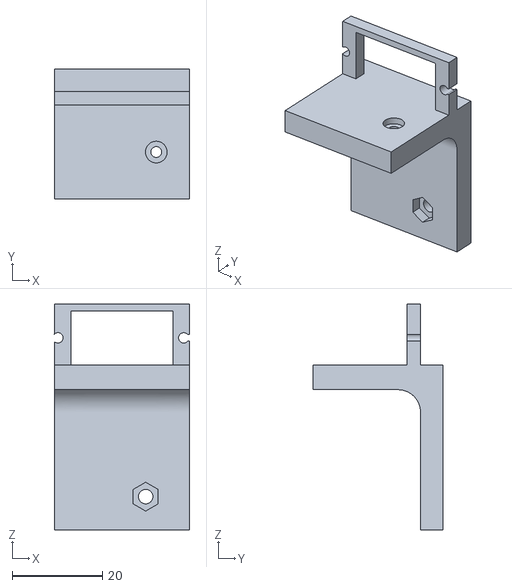
[picture p63: CAD file, 2022-07-29]
3d model/ClipServoHousing.stl
30.0 x 28.9 x 50.1
