Szu-Chi/Ant_Robot/3d model/Spur Gear (14 teeth).stl

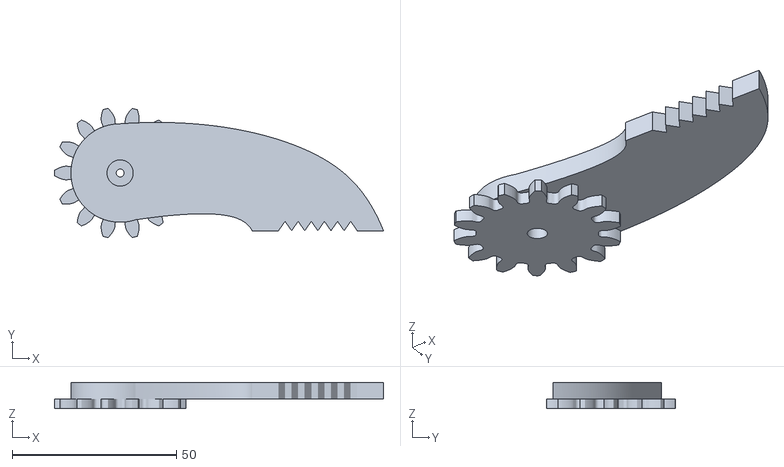
[picture p64: CAD file, 2022-07-29]
3d model/Spur Gear (14 teeth).stl
100.2 x 39.3 x 8.00
