Szu-Chi/Ant_Robot/3d model/Spur Gear (14 teeth)(Mirror).stl

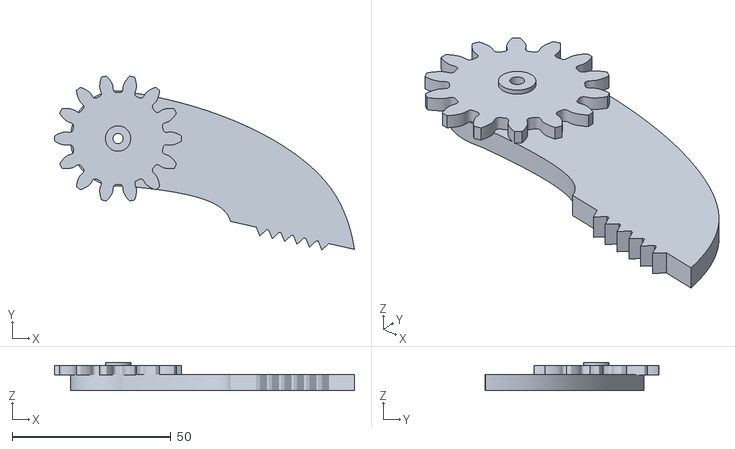
[picture p65: CAD file, 2022-07-29]
3d model/Spur Gear (14 teeth)(Mirror).stl
94.4 x 54.7 x 8.85
