Szu-Chi/Ant_Robot/3d model/Body.stl

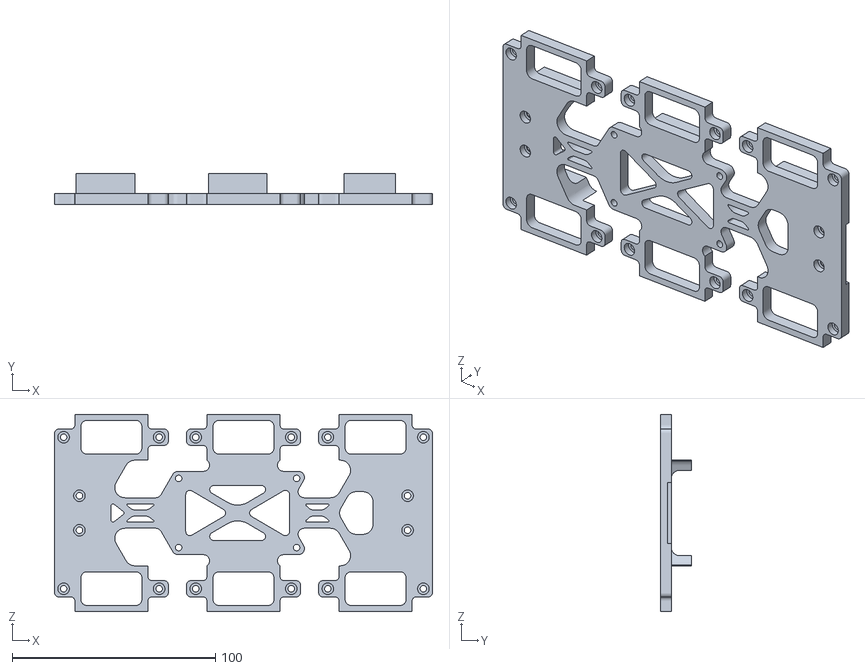
[picture p66: CAD file, 2022-07-29]
3d model/Body.stl
186.0 x 15.4 x 97.2
