Szu-Chi/Ant_Robot/3d model/abdomen (1).stl

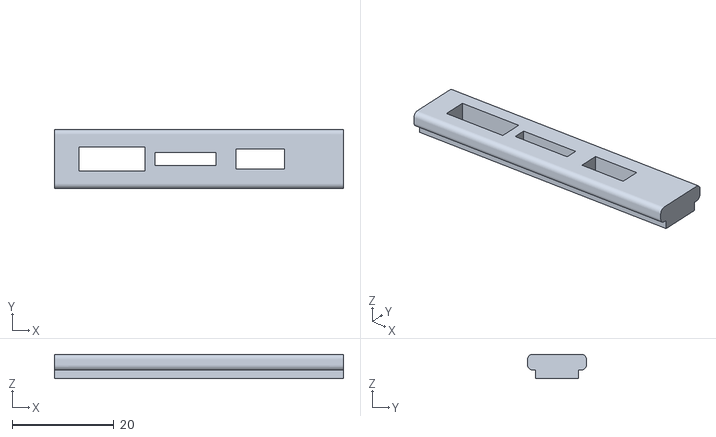
[picture p67: CAD file, 2022-07-29, an earlier design]
3d model/abdomen (1).stl
57.0 x 11.6 x 4.80
