Szu-Chi/Ant_Robot/3d model/neck (1).stl

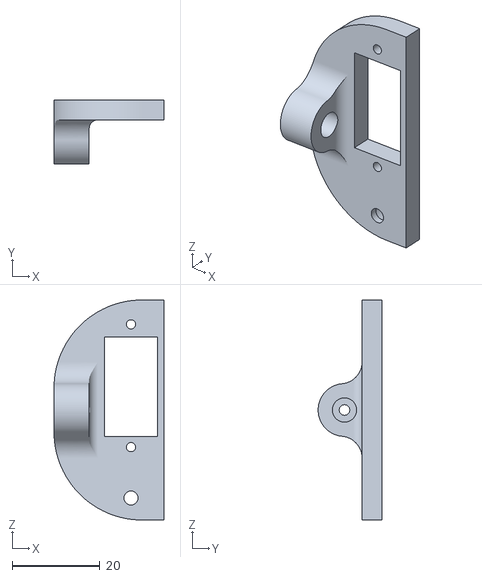
[picture p68: CAD file, 2022-07-29, an earlier design]
3d model/neck (1).stl
25.0 x 14.5 x 50.0
