Szu-Chi/Ant_Robot/(list of files, cad)

Other CAD files:
3d model/foot(Mirror).stl
3d model/ServoHousing(Mirror).stl
