Szu-Chi/Ant_Robot/(list of files, drawings)

Other design files:
circuit/Ant_Robot/Ant_Robot.PcbDoc
circuit/Ant_Robot/Ant_Robot.PrjPCB
circuit/Ant_Robot/Ant_Robot.SchDoc
circuit/Ant_Robot_Controller/Ant_Robot_Controller.PcbDoc
circuit/Ant_Robot_Controller/Ant_Robot_Controller.PrjPCB
circuit/Ant_Robot_Controller/Ant_Robot_Controller.SchDoc
