Szu-Chi/Ant_Robot/firmware/Robot_Ant_Controller/Robot_Ant_Controller(STM32F103ZE)/Src/main.c

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
/* Includes ------------------------------------------------------------------*/
#include "main.h"

ADC_HandleTypeDef hadc1;
DMA_HandleTypeDef hdma_adc1;

UART_HandleTypeDef huart1;

/* USER CODE BEGIN PV */

/* USER CODE END PV */

void SystemClock_Config(void);
static void MX_GPIO_Init(void);
static void MX_DMA_Init(void);
static void MX_ADC1_Init(void);
static void MX_USART1_UART_Init(void);
/* USER CODE BEGIN PFP */

/* USER CODE END PFP */

/* USER CODE BEGIN 0 */
uint8_t str[7];
uint8_t sw1=0,sw2=0,Speed=0,delay=0,sw_clip=0;
uint32_t adc_temp[5];
uint32_t X1_Value=2048,Y1_Value=2048,X2_Value=0,Y2_Value=0,VR_Value=0;

void HAL_ADC_ConvCpltCallback(ADC_HandleTypeDef* hadc)
{
	X1_Value = adc_temp[0];
	Y1_Value = adc_temp[1];
	X2_Value = adc_temp[2];
	Y2_Value = adc_temp[3];
	VR_Value = adc_temp[4];
}

long map(long x, long in_min, long in_max, long out_min, long out_max)
{
  return (x - in_min) * (out_max - out_min) / (in_max - in_min) + out_min;
}

/* USER CODE END 0 */

/**
  * @brief  The application entry point.
  * @retval int
  */
int main(void)
{
  /* MCU Configuration--------------------------------------------------------*/

  /* Reset of all peripherals, Initializes the Flash interface and the Systick. */
  HAL_Init();

  /* Configure the system clock */
  SystemClock_Config();

  /* Initialize all configured peripherals */
  MX_GPIO_Init();
  MX_DMA_Init();
  MX_ADC1_Init();
  MX_USART1_UART_Init();
  /* USER CODE BEGIN 2 */
	HAL_ADC_Start_DMA(&hadc1,adc_temp,5);
	str[0] = 'S';
	HAL_GPIO_WritePin(GPIOF,GPIO_PIN_6, GPIO_PIN_RESET);
	HAL_GPIO_WritePin(GPIOF,GPIO_PIN_7, GPIO_PIN_RESET);
	HAL_GPIO_WritePin(GPIOF,GPIO_PIN_8, GPIO_PIN_RESET);
	HAL_GPIO_WritePin(GPIOF,GPIO_PIN_9, GPIO_PIN_RESET);
  /* USER CODE END 2 */

  /* Infinite loop */
  /* USER CODE BEGIN WHILE */
  while (1)
  {
		sw1 = HAL_GPIO_ReadPin(GPIOB,GPIO_PIN_8);
		sw2 = HAL_GPIO_ReadPin(GPIOB,GPIO_PIN_9);
		
		uint8_t angle1 = map(X2_Value,0,4095,0,180);
		uint8_t angle2 = map(Y2_Value,0,4095,0,180);
		uint8_t angle3 = map(VR_Value,0,4040,0,180);
		if(sw2==1)
		{
			sw_clip=~sw_clip;
			sw_clip&=0x01;
			while(HAL_GPIO_ReadPin(GPIOB,GPIO_PIN_9));
		}
		
		if(sw1==1)
		{ str[0] = 'S'; }
		else if(Y1_Value<=1000)
		{
			str[0] = 'F';
			if(delay++>=50)
			{
				delay = 0;
				if(Speed<5)
				{ Speed++; }
				HAL_GPIO_TogglePin(GPIOF,GPIO_PIN_8);
				HAL_GPIO_TogglePin(GPIOF,GPIO_PIN_7);
			}	
		}
		else if(Y1_Value>=3000)
		{
			if(delay++>=50)
			{
				delay = 0;
				if(Speed>0)
				{ Speed--; }
				HAL_GPIO_TogglePin(GPIOF,GPIO_PIN_6);
				HAL_GPIO_TogglePin(GPIOF,GPIO_PIN_9);
			}
		}
		else if(X1_Value>=3000)
		{ 
			str[0] = 'R'; 
			if(delay++>=30)
			{
				delay = 0;
				HAL_GPIO_TogglePin(GPIOF,GPIO_PIN_6);
				HAL_GPIO_TogglePin(GPIOF,GPIO_PIN_7);
			}
		}
		else if(X1_Value<=1300)
		{ 
			str[0] = 'L'; 
			if(delay++>=30)
			{
				delay = 0;
				HAL_GPIO_TogglePin(GPIOF,GPIO_PIN_8);
				HAL_GPIO_TogglePin(GPIOF,GPIO_PIN_9);
			}
		}
		else
		{
			HAL_GPIO_WritePin(GPIOF,GPIO_PIN_6,GPIO_PIN_RESET);
			HAL_GPIO_WritePin(GPIOF,GPIO_PIN_7,GPIO_PIN_RESET);
			HAL_GPIO_WritePin(GPIOF,GPIO_PIN_8,GPIO_PIN_RESET);
			HAL_GPIO_WritePin(GPIOF,GPIO_PIN_9,GPIO_PIN_RESET);
		}
		
		str[1] = Speed;
		str[2] = angle1;
		str[3] = angle2;
		str[4] = angle3;
		str[5] = sw_clip;
		str[6] = 'E';
		HAL_UART_Transmit(&huart1,str,7,0xffF);
		HAL_Delay(10);
    /* USER CODE END WHILE */

    /* USER CODE BEGIN 3 */

  }
  /* USER CODE END 3 */
}

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
