Szu-Chi/Ant_Robot/firmware/Robot_Ant_Controller/Robot_Ant_Controller(STM32F103ZE)/Robot_Ant_Controller(STM32F103ZE).ioc

Mcu.UserName=STM32F103ZETx
PA10.Signal=USART1_RX
PA13.Signal=SYS_JTMS-SWDIO
PA14.Signal=SYS_JTCK-SWCLK
PA15.Signal=SYS_JTDI
PA2.Signal=ADCx_IN2
PA3.Signal=ADCx_IN3
PA9.Signal=USART1_TX
PB3.Signal=SYS_JTDO-TRACESWO
PB4.Signal=SYS_NJTRST
PB8.Signal=GPIO_Input
PB9.Signal=GPIO_Input
PC2.Signal=ADCx_IN12
PC3.Signal=ADCx_IN13
PC4.Signal=ADCx_IN14
PF6.Signal=GPIO_Output
PF7.Signal=GPIO_Output
PF8.Signal=GPIO_Output
PF9.Signal=GPIO_Output
