Szu-Chi/Ant_Robot/firmware/Robot_Ant/Robot_Ant/Src/main.c

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
/* Includes ------------------------------------------------------------------*/
#include "main.h"

/* USER CODE BEGIN Includes */

#include "string.h"
#include "PCA9685.h"

/* USER CODE END Includes */

I2C_HandleTypeDef hi2c1;

TIM_HandleTypeDef htim6;

UART_HandleTypeDef huart2;

/* USER CODE BEGIN PV */

/* USER CODE END PV */

void SystemClock_Config(void);
static void MX_GPIO_Init(void);
static void MX_TIM6_Init(void);
static void MX_USART2_UART_Init(void);
static void MX_I2C1_Init(void);
/* USER CODE BEGIN PFP */

/* USER CODE END PFP */

/* USER CODE BEGIN 0 */

uint8_t str1[7], command = 'S',speed = 0, clip = 0;
int angle1 = 0, angle2 = 0, angle3 = 0;
int horizontal = 97, vertical = 96, roll = 90;

void Control_Clip(void) {
	horizontal = map((180-angle1), 0, 180, 60, 120) + 6;
	vertical = map((180-angle2), 0, 180, 60, 120) + 6;
	roll = map((180-angle3), 0, 180, 60, 120);
	
	setAngle(6, horizontal);
	setAngle(7, vertical);
	setAngle(8, roll);
	if(clip == 1)
		setAngle(9, 90); 
	else
		setAngle(9, 0);
}

void Move_Forword(void) {
	for(int i=60;i<=120;i+=3) {
		if(command != 'F') break; 
		setAngle(1, i);
		setAngle(4, i);	
		Control_Clip();
		HAL_Delay((5-speed)+1);
	}
	
	for(int i=180;i>=0;i-=3) {
		if(command!='F') break;
		setAngle(3,	i);
		setAngle(5,	i);
		setAngle(0,	i);
		setAngle(2,	i);
		Control_Clip();
		HAL_Delay((5-speed));
	}
	
	for(int i=120;i>=60;i-=3) {
		if(command!='F') break; 
		setAngle(1,i);
		setAngle(4,i);
		Control_Clip();
		HAL_Delay((5-speed)+1);
	}
	
	for(int i=0;i<=180;i+=3) {
		if(command!='F') break; 
		setAngle(3,i);
		setAngle(5,i);
		setAngle(0,i);
		setAngle(2,i);
		Control_Clip();
		HAL_Delay((5-speed));
	}
}

void Turn_Right(void) {
	for(int i=60;i<=120;i+=2) {
		if(command!='R') break; 
		setAngle(1,i);
		setAngle(4,i);	
		Control_Clip();
	}
	
	for(int i=0;i<=180;i+=2) {
		if(command!='R') break; 
		setAngle(3,180-i);
		setAngle(5,180-i);
		setAngle(0,i);
		setAngle(2,i);
		Control_Clip();
	}
	
	for(int i=120;i>=60;i-=2) {
		if(command!='R') break; 
		setAngle(1,i);
		setAngle(4,i);
		Control_Clip();
	}
	
	for(int i=180;i>=0;i-=2) {
		if(command!='R') break; 
		setAngle(3,180-i);
		setAngle(5,180-i);
		setAngle(0,i);
		setAngle(2,i);
		Control_Clip();
	}
}

void Turn_Left(void) {
	for(int i=60;i<=120;i+=2) {
		if(command!='L') break; 
		setAngle(1,i);
		setAngle(4,i);	
		Control_Clip();
	}
	
	for(int i=0;i<=180;i+=2) {
		if(command!='L') break; 
		setAngle(3,i);
		setAngle(5,i);
		setAngle(0,180-i);
		setAngle(2,180-i);
		Control_Clip();
	}
	
	for(int i=120;i>=60;i-=2) {
		if(command!='L') break; 
		setAngle(1,i);
		setAngle(4,i);
		Control_Clip();
	}
	
	for(int i=180;i>=0;i-=2) {
		if(command!='L') break; 
		setAngle(3,i);
		setAngle(5,i);
		setAngle(0,180-i);
		setAngle(2,180-i);
		Control_Clip();
	}
}

void Reset_Position(void) {
	for(int i=0;i<6;i++)
		setAngle(i,90); 
	Control_Clip();
}


void HAL_UART_RxCpltCallback(UART_HandleTypeDef *huart) {
  if(huart->Instance==USART2) {
		if(str1[6]=='E') {
			command = str1[0];
			speed = str1[1];
			angle1 = (int)str1[2];
			angle2 = (int)str1[3];
			angle3 = (int)str1[4];
			clip = str1[5];
		}
		HAL_UART_Receive_IT(&huart2,str1,7); //Enable rx interrupt every time
  }
}


/* USER CODE END 0 */

/**
  * @brief  The application entry point.
  * @retval int
  */
int main(void)
{
  /* MCU Configuration--------------------------------------------------------*/

  /* Reset of all peripherals, Initializes the Flash interface and the Systick. */
  HAL_Init();

  /* Configure the system clock */
  SystemClock_Config();

  /* Initialize all configured peripherals */
  MX_GPIO_Init();
  MX_TIM6_Init();
  MX_USART2_UART_Init();
  MX_I2C1_Init();
  /* USER CODE BEGIN 2 */
	
	PWMServo_Init();
	HAL_Delay(10); 
	HAL_GPIO_WritePin(OE_GPIO_Port, OE_Pin, GPIO_PIN_RESET);	
	HAL_GPIO_WritePin(EN_GPIO_Port, EN_Pin, GPIO_PIN_RESET);	
	HAL_Delay(10);
	Reset_Position();
	HAL_Delay(10);
	HAL_UART_Receive_IT(&huart2, str1, 7);
	
  /* USER CODE END 2 */

  /* Infinite loop */
  /* USER CODE BEGIN WHILE */
  while (1)
  {
		
		if(command=='F')
			Move_Forword(); 
		else if(command=='R')
			Turn_Right(); 
		else if(command=='L')
			Turn_Left(); 
		else if(command=='S')
			Reset_Position(); 

		
    /* USER CODE END WHILE */

    /* USER CODE BEGIN 3 */

  }
  /* USER CODE END 3 */
}

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
