Szu-Chi/Ant_Robot/firmware/Robot_Ant/Robot_Ant/Inc/main.h

#define EN_Pin GPIO_PIN_4
#define EN_GPIO_Port GPIOA
#define OE_Pin GPIO_PIN_10
#define OE_GPIO_Port GPIOB
