Szu-Chi/Ant_Robot/(commit log)

2022-07-29 add 3d model & doc
    [Body.stl, ClipServoHousing.stl, Head.stl, Latch1(Mirror).stl, Servo Housing_Latch(Mirror).stl, ServoHousing(Mirror).stl, ServoHousing.stl, Spur Gear (14 teeth)(Mirror).stl]
2022-07-31 Daniel => Add main circuit of robot
    [Ant_Robot.PcbDoc, Ant_Robot.PrjPCB, Ant_Robot.SchDoc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]
2022-07-31 Daniel => Add circuit of robot controller(Shield board)
    [Ant_Robot_Controller.PcbDoc, Ant_Robot_Controller.PrjPCB, Ant_Robot_Controller.SchDoc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]
2022-07-31 Daniel => Add README for circuit
