Szu-Chi/Ant_Robot/(notices)

Notices in the files:
firmware/Robot_Ant/Robot_Ant/Src/main.c:
Copyright (c) 2022 STMicroelectronics.
All rights reserved.
This software is licensed under terms that can be found in the LICENSE file
